NordOtto/Pumpensteuerung/hardware/bom.csv

Menge | Referenzen | Wert | Footprint | MPN/Hinweis
1 | C1 | 100µF/50V | CP_Elec_10x10.5
4 | C2 C3 C10 C11 | 10µ/50V | C_1210_3225Metric
2 | C4 C12 | 100n/50V | C_0603_1608Metric
4 | C5 C13 C23 C29 | 1µ | C_0603_1608Metric
11 | C6 C14 C18 C22 C25 C40 C41 C44 C57 C58 C60 | 100nF | C_0603_1608Metric
4 | C7 C8 C9 C33 | 22µ/16V | C_1210_3225Metric
2 | C15 C16 | 22µ/25V | C_1210_3225Metric
1 | C17 | 10µF/16V | C_0805_2012Metric
2 | C19 C20 | 22µF/10V | C_1210_3225Metric
4 | C21 C45 C56 C59 | 10µF | C_0805_2012Metric
1 | C24 | 22µF/16V | C_1210_3225Metric
1 | C26 | 10µ | C_0805_2012Metric
5 | C27 C28 C42 C43 C61 | 100n | C_0603_1608Metric
1 | C30 | 470p | C_0603_1608Metric
2 | C31 C32 | 22p | C_0603_1608Metric
6 | C34 C35 C36 C37 C38 C39 | 10n | C_0603_1608Metric
2 | C46 C49 | 100nF/50V | C_0603_1608Metric
2 | C47 C50 | 2.2nF | C_0603_1608Metric
2 | C48 C51 | 10nF/50V | C_0603_1608Metric
4 | C52 C53 C54 C55 | 10nF | C_0603_1608Metric
1 | D1 | SMAJ30A | D_SMA
1 | D2 | SS14 | D_SMA
1 | D3 | grün PWR | LED_0603_1608Metric
1 | D4 | gelb STATUS | LED_0603_1608Metric
1 | D5 | blau APP | LED_0603_1608Metric
8 | D6 D7 D8 D9 D10 D11 D13 D15 | SMAJ26A | D_SMA
8 | D12 D14 D17 D19 D21 D23 D24 D26 | 1N4148W | D_SOD-123
4 | D16 D18 D20 D22 | BZT52C9V1 | D_SOD-123
1 | D25 | rot K1 | LED_0603_1608Metric
1 | D27 | rot K2 | LED_0603_1608Metric
2 | D28 D29 | SMAJ15CA | D_SMA
1 | F1 | T2A 250V | Fuseholder_Clip-5x20mm_Keystone_3517_Inline_P23.11x6.76mm_D1.70mm_Horizontal
1 | F2 | 1.1A hold | Fuse_1812_4532Metric | Bourns MF-MSMF110-2
12 | F3 F4 F5 F6 F7 F8 F9 F10 F11 F12 F13 F14 | 50mA | Fuse_1206_3216Metric | Bourns MF-USMF005-2
1 | F15 | 200mA | Fuse_1206_3216Metric | Bourns MF-USMF020-2
1 | FB1 | 600Ω@100MHz | L_0603_1608Metric
4 | H1 H2 H3 H4 | M3 | MountingHole_3.2mm_M3
1 | J1 | 230V L/N | TerminalBlock_Phoenix_MKDS-1,5-2-5.08_1x02_P5.08mm_Horizontal
1 | J2 | USB-C S3 | USB_C_Receptacle_HRO_TYPE-C-31-M-12
1 | J3 | Erweiterung S3 | PinHeader_1x10_P2.54mm_Vertical
1 | J4 | Erweiterung P4 | PinHeader_1x05_P2.54mm_Vertical
1 | J5 | HR911105A | RJ45_Hanrun_HR911105A_Horizontal
1 | J6 | DSI 15p 1.0mm | TE_1-84952-5_1x15-1MP_P1.0mm_Horizontal | TE 1-84952-5
1 | J7 | Display 5V | PinHeader_1x02_P2.54mm_Vertical
1 | J8 | AI1 | TerminalBlock_Phoenix_PT-1,5-3-3.5-H_1x03_P3.50mm_Horizontal
1 | J9 | AI2 | TerminalBlock_Phoenix_PT-1,5-3-3.5-H_1x03_P3.50mm_Horizontal
1 | J10 | AI3 | TerminalBlock_Phoenix_PT-1,5-3-3.5-H_1x03_P3.50mm_Horizontal
1 | J11 | AI4 | TerminalBlock_Phoenix_PT-1,5-3-3.5-H_1x03_P3.50mm_Horizontal
1 | J12 | AI5 | TerminalBlock_Phoenix_PT-1,5-3-3.5-H_1x03_P3.50mm_Horizontal
1 | J13 | AI6 | TerminalBlock_Phoenix_PT-1,5-3-3.5-H_1x03_P3.50mm_Horizontal
1 | J14 | AO1 | TerminalBlock_Phoenix_PT-1,5-2-3.5-H_1x02_P3.50mm_Horizontal
1 | J15 | AO2 | TerminalBlock_Phoenix_PT-1,5-2-3.5-H_1x02_P3.50mm_Horizontal
1 | J16 | DI | TerminalBlock_Phoenix_PT-1,5-6-3.5-H_1x06_P3.50mm_Horizontal
1 | J17 | K1 | TerminalBlock_Phoenix_MKDS-1,5-3-5.08_1x03_P5.08mm_Horizontal
1 | J18 | K2 | TerminalBlock_Phoenix_MKDS-1,5-3-5.08_1x03_P5.08mm_Horizontal
1 | J19 | RS485 | TerminalBlock_Phoenix_PT-1,5-3-3.5-H_1x03_P3.50mm_Horizontal
1 | J20 | Lüfter 4-Pin | FanPinHeader_1x04_P2.54mm_Vertical
6 | JP1 JP2 JP3 JP4 JP5 JP6 | 4-20mA | PinHeader_1x02_P2.54mm_Vertical
1 | JP7 | 120Ω | PinHeader_1x02_P2.54mm_Vertical
2 | K1 K2 | 34.51.7.024.0010 | Relay_SPDT_Finder_34.51_Vertical | Finder 34.51.7.024.0010
1 | L1 | 10µH | L_Bourns_SRP7028A_7.3x6.6mm | Bourns SRP7028A-100M
1 | L2 | 22µH | L_Bourns_SRP7028A_7.3x6.6mm | Bourns SRP7028A-220M
1 | L3 | 4.7µH | L_Bourns-SRN6028 | Bourns SRN6028-4R7M
1 | PS1 | IRM-30-24 | MeanWell_IRM-30 | Mean Well IRM-30-24
5 | Q1 Q2 Q3 Q8 Q9 | 2N7002 | SOT-23
2 | Q4 Q6 | MMBT2907A | SOT-23
2 | Q5 Q7 | BSP170P | SOT-223-3_TabPin2
7 | R1 R5 R11 R13 R60 R77 R80 | 100k | R_0603_1608Metric
2 | R2 R6 | 12k | R_0603_1608Metric
3 | R3 R7 R55 | 100k 1% | R_0603_1608Metric
1 | R4 | 24.9k 1% | R_0603_1608Metric
1 | R8 | 9.09k 1% | R_0603_1608Metric
1 | R9 | 2.2k | R_0603_1608Metric
15 | R10 R12 R16 R25 R26 R53 R54 R61 R69 R71 R73 R75 R82 R84 R85 | 10k | R_0603_1608Metric
2 | R14 R15 | 5.1k | R_0603_1608Metric
2 | R17 R21 | 470 | R_0603_1608Metric
6 | R18 R19 R33 R34 R78 R81 | 4.7k | R_0603_1608Metric
4 | R20 R59 R76 R79 | 100 | R_0603_1608Metric
1 | R22 | 12.1k 1% | R_0603_1608Metric
1 | R23 | 33 | R_0603_1608Metric
1 | R24 | 1.5k | R_0603_1608Metric
4 | R27 R28 R29 R30 | 49.9 | R_0603_1608Metric
2 | R31 R32 | 330 | R_0603_1608Metric
6 | R35 R38 R41 R44 R47 R50 | 150 0.1% 1W | R_2512_6332Metric
6 | R36 R39 R42 R45 R48 R51 | 22k 0.1% | R_0603_1608Metric
6 | R37 R40 R43 R46 R49 R52 | 10k 0.1% | R_0603_1608Metric
3 | R56 R57 R58 | 10k 1% | R_0603_1608Metric
2 | R62 R65 | 1.00k 0.1% | R_0603_1608Metric
4 | R63 R64 R66 R67 | 15 | R_0603_1608Metric
4 | R68 R70 R72 R74 | 3.3k | R_1206_3216Metric
1 | R83 | 120 | R_1206_3216Metric
1 | RV1 | S10K275 | RV_Disc_D12mm_W4.2mm_P7.5mm
1 | SW1 | RESET | SW_SPST_TL3342
1 | SW2 | BOOT | SW_SPST_TL3342
1 | SW3 | SERVICE | SW_SPST_TL3342
1 | SW4 | RESET P4 | SW_SPST_TL3342
1 | SW5 | BOOT P4 | SW_SPST_TL3342
2 | U1 U2 | LMR33630ADDA | Texas_HSOP-8-1EP_3.9x4.9mm_P1.27mm_ThermalVias | LMR33630ADDAR
1 | U3 | AP63203WU-7 | TSOT-23-6 | AP63203WU-7
1 | U4 | ESP32-S3-WROOM-1-N16R8 | ESP32-S3-WROOM-1 | ESP32-S3-WROOM-1-N16R8
1 | U5 | M5Stack Stamp-P4 | M5Stack_Stamp-P4 | M5Stack S013 Stamp-P4
1 | U6 | LAN8720A-CP | VQFN-24-1EP_4x4mm_P0.5mm_EP2.5x2.5mm_ThermalVias | LAN8720A-CP-TR
2 | U7 U8 | ADS1115IDGS | TSSOP-10_3x3mm_P0.5mm
1 | U9 | MCP4728-E/UN | MSOP-10_3x3mm_P0.5mm
2 | U10 U11 | XTR111AIDGQR | MSOP-10-1EP_3x3mm_P0.5mm_EP2.2x3.1mm_Mask1.83x1.89mm_ThermalVias
1 | U12 | TLP293-4 | SOIC-16_4.55x10.3mm_P1.27mm
1 | U13 | ADM2587EBRWZ | SOIC-20W_7.5x12.8mm_P1.27mm
1 | U14 | 74LVC1G07 | SOT-23-5
1 | Y1 | 25MHz | Crystal_SMD_3225-4Pin_3.2x2.5mm
