NordOtto/Pumpensteuerung/hardware/kicad/analog_in.kicad_sch

## KiCad design hardware/kicad/analog_in.kicad_sch (2026-10-20)

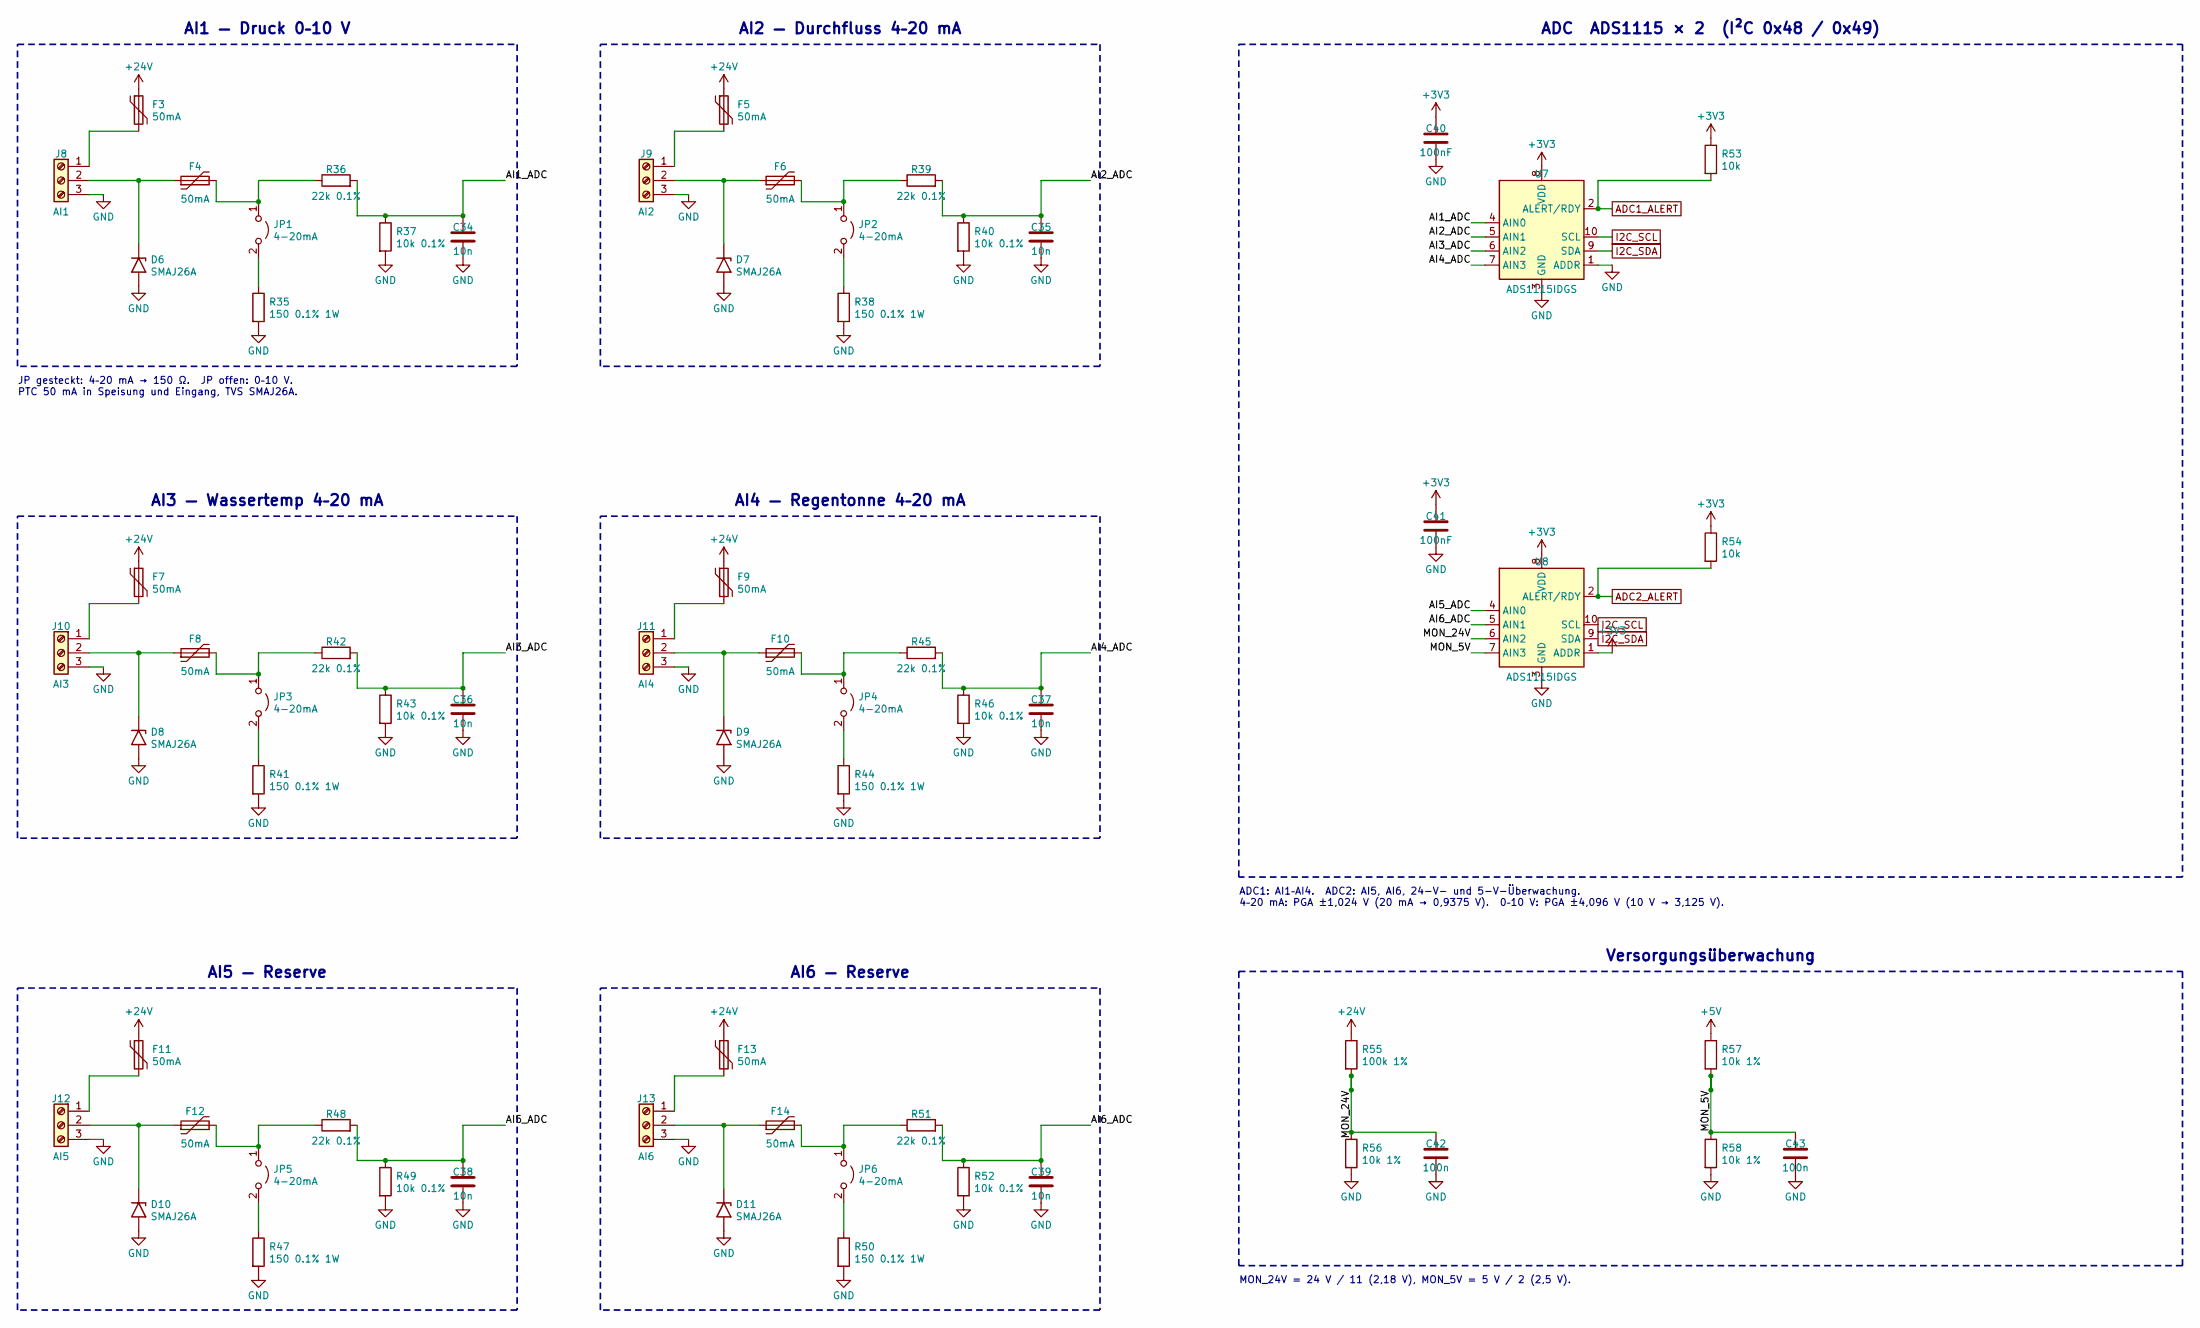
[picture p1: schematic analog_in.kicad_sch]

Parts:
C34, C35, C36, C37, C38, C39: 10n; C_0603_1608Metric
C40, C41: 100nF; C_0603_1608Metric
C42, C43: 100n; C_0603_1608Metric
D6, D7, D8, D9, D10, D11: SMAJ26A; D_SMA
F3, F4, F5, F6, F7, F8, F9, F10, F11, F12, F13, F14: 50mA; Fuse_1206_3216Metric; MPN Bourns MF-USMF005-2
J8: AI1; TerminalBlock_Phoenix_PT-1,5-3-3.5-H_1x03_P3.50mm_Horizontal
J9: AI2; TerminalBlock_Phoenix_PT-1,5-3-3.5-H_1x03_P3.50mm_Horizontal
J10: AI3; TerminalBlock_Phoenix_PT-1,5-3-3.5-H_1x03_P3.50mm_Horizontal
J11: AI4; TerminalBlock_Phoenix_PT-1,5-3-3.5-H_1x03_P3.50mm_Horizontal
J12: AI5; TerminalBlock_Phoenix_PT-1,5-3-3.5-H_1x03_P3.50mm_Horizontal
J13: AI6; TerminalBlock_Phoenix_PT-1,5-3-3.5-H_1x03_P3.50mm_Horizontal
JP1, JP2, JP3, JP4, JP5, JP6: 4-20mA; PinHeader_1x02_P2.54mm_Vertical
R35, R38, R41, R44, R47, R50: 150 0.1% 1W; R_2512_6332Metric
R36, R39, R42, R45, R48, R51: 22k 0.1%; R_0603_1608Metric
R37, R40, R43, R46, R49, R52: 10k 0.1%; R_0603_1608Metric
R53, R54: 10k; R_0603_1608Metric
R55: 100k 1%; R_0603_1608Metric
R56, R57, R58: 10k 1%; R_0603_1608Metric
U7, U8: ADS1115IDGS; TSSOP-10_3x3mm_P0.5mm

Connections:
+3V3: C40.1, C41.1, R53.1, R54.1, U7.8 (VDD), U8.1 (ADDR), U8.8 (VDD)
+5V: R57.1
+24V: F3.1, F5.1, F7.1, F9.1, F11.1, F13.1, R55.1
ADC1_ALERT: R53.2, U7.2 (ALERT/RDY)
ADC2_ALERT: R54.2, U8.2 (ALERT/RDY)
AI1_ADC: C34.1, R36.2, R37.1, U7.4 (AIN0)
AI2_ADC: C35.1, R39.2, R40.1, U7.5 (AIN1)
AI3_ADC: C36.1, R42.2, R43.1, U7.6 (AIN2)
AI4_ADC: C37.1, R45.2, R46.1, U7.7 (AIN3)
AI5_ADC: C38.1, R48.2, R49.1, U8.4 (AIN0)
AI6_ADC: C39.1, R51.2, R52.1, U8.5 (AIN1)
GND: C34.2, C35.2, C36.2, C37.2, C38.2, C39.2, C40.2, C41.2, C42.2, C43.2, D6.2 (A2), D7.2 (A2), D8.2 (A2), D9.2 (A2), D10.2 (A2), D11.2 (A2), J8.3, J9.3, J10.3, J11.3, J12.3, J13.3, R35.2, R37.2, R38.2, R40.2, R41.2, R43.2, R44.2, R46.2, R47.2, R49.2, R50.2, R52.2, R56.2, R58.2, U7.1 (ADDR), U7.3 (GND), U8.3 (GND)
I2C_SCL: U7.10 (SCL), U8.10 (SCL)
I2C_SDA: U7.9 (SDA), U8.9 (SDA)
MON_5V: C43.1, R57.2, R58.1, U8.7 (AIN3)
MON_24V: C42.1, R55.2, R56.1, U8.6 (AIN2)
unnamed: D6.1 (A1), F4.1, J8.2
unnamed: D7.1 (A1), F6.1, J9.2
unnamed: D8.1 (A1), F8.1, J10.2
unnamed: D9.1 (A1), F10.1, J11.2
unnamed: D10.1 (A1), F12.1, J12.2
unnamed: D11.1 (A1), F14.1, J13.2
unnamed: F3.2, J8.1
unnamed: F4.2, JP1.1 (A), R36.1
unnamed: F5.2, J9.1
unnamed: F6.2, JP2.1 (A), R39.1
unnamed: F7.2, J10.1
unnamed: F8.2, JP3.1 (A), R42.1
unnamed: F9.2, J11.1
unnamed: F10.2, JP4.1 (A), R45.1
unnamed: F11.2, J12.1
unnamed: F12.2, JP5.1 (A), R48.1
unnamed: F13.2, J13.1
unnamed: F14.2, JP6.1 (A), R51.1
unnamed: JP1.2 (B), R35.1
unnamed: JP2.2 (B), R38.1
unnamed: JP3.2 (B), R41.1
unnamed: JP4.2 (B), R44.1
unnamed: JP5.2 (B), R47.1
unnamed: JP6.2 (B), R50.1

Notes on the sheet:
AI1 — Druck 0–10 V
JP gesteckt: 4–20 mA → 150 Ω. JP offen: 0–10 V. PTC 50 mA in Speisung und Eingang, TVS SMAJ26A.
AI2 — Durchfluss 4–20 mA
AI3 — Wassertemp 4–20 mA
AI4 — Regentonne 4–20 mA
AI5 — Reserve
AI6 — Reserve
ADC ADS1115 × 2 (I²C 0x48 / 0x49)
ADC1: AI1–AI4. ADC2: AI5, AI6, 24-V- und 5-V-Überwachung. 4–20 mA: PGA ±1,024 V (20 mA → 0,9375 V). 0–10 V: PGA ±4,096 V (10 V → 3,125 V).
Versorgungsüberwachung
MON_24V = 24 V / 11 (2,18 V), MON_5V = 5 V / 2 (2,5 V).
