NordOtto/Pumpensteuerung/hardware/kicad/analog_out.kicad_sch

## KiCad design hardware/kicad/analog_out.kicad_sch (2026-10-20)

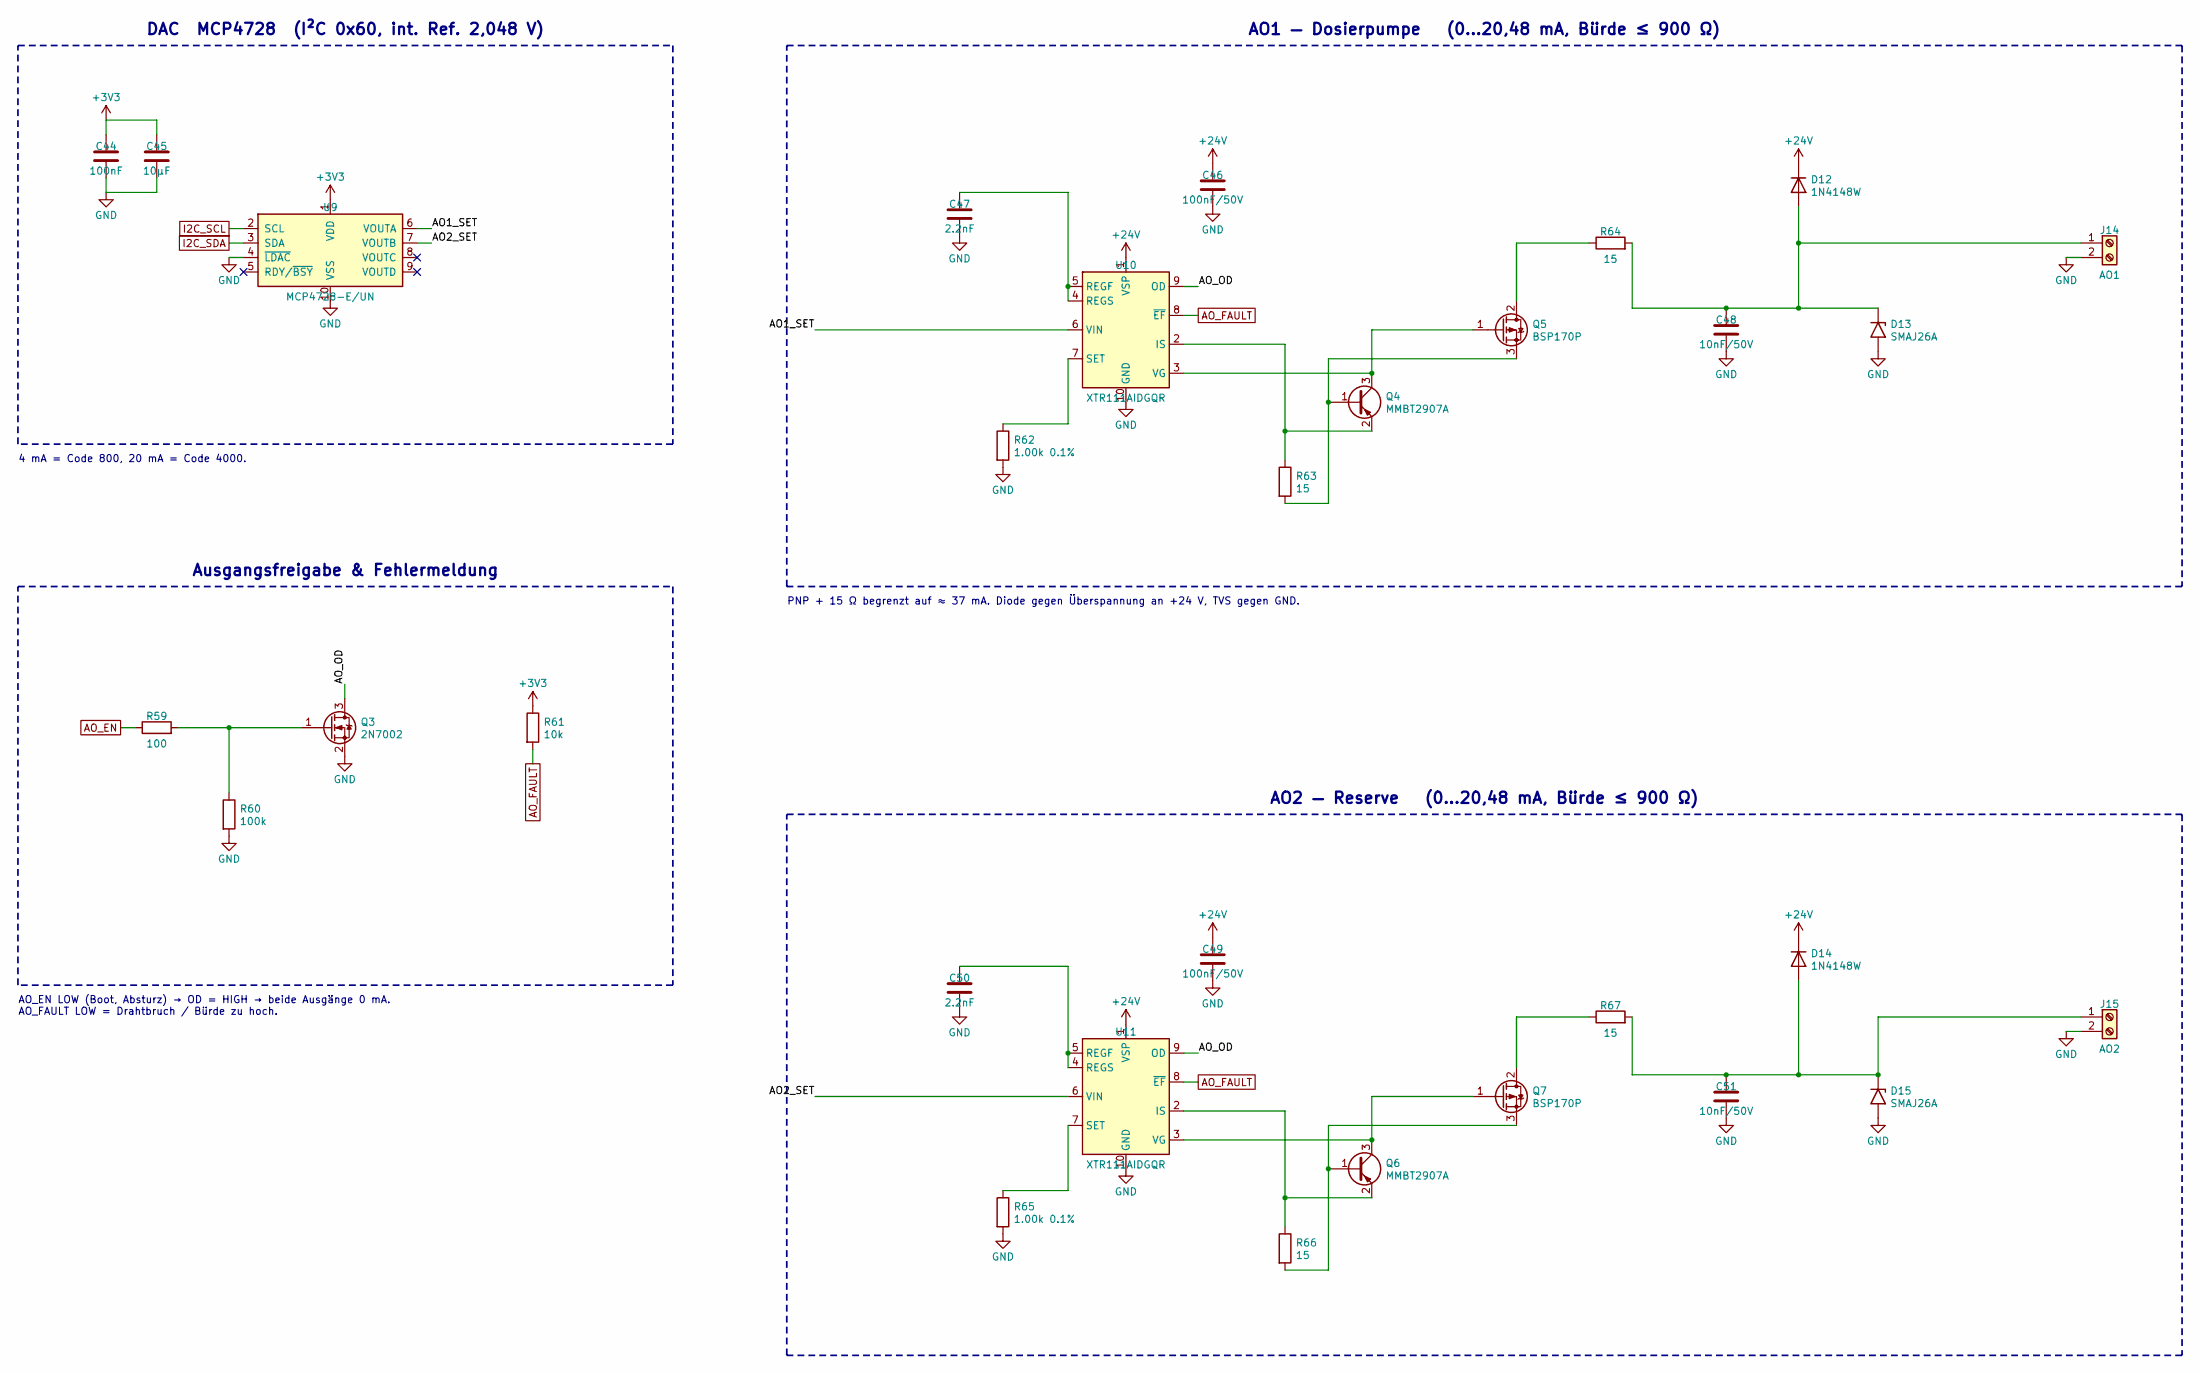
[picture p2: schematic analog_out.kicad_sch]

Parts:
C44: 100nF; C_0603_1608Metric
C45: 10µF; C_0805_2012Metric
C46, C49: 100nF/50V; C_0603_1608Metric
C47, C50: 2.2nF; C_0603_1608Metric
C48, C51: 10nF/50V; C_0603_1608Metric
D12, D14: 1N4148W; D_SOD-123
D13, D15: SMAJ26A; D_SMA
J14: AO1; TerminalBlock_Phoenix_PT-1,5-2-3.5-H_1x02_P3.50mm_Horizontal
J15: AO2; TerminalBlock_Phoenix_PT-1,5-2-3.5-H_1x02_P3.50mm_Horizontal
Q3: 2N7002; SOT-23
Q4, Q6: MMBT2907A; SOT-23
Q5, Q7: BSP170P; SOT-223-3_TabPin2
R59: 100; R_0603_1608Metric
R60: 100k; R_0603_1608Metric
R61: 10k; R_0603_1608Metric
R62, R65: 1.00k 0.1%; R_0603_1608Metric
R63, R64, R66, R67: 15; R_0603_1608Metric
U9: MCP4728-E/UN; MSOP-10_3x3mm_P0.5mm
U10, U11: XTR111AIDGQR; MSOP-10-1EP_3x3mm_P0.5mm_EP2.2x3.1mm_Mask1.83x1.89mm_Therma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

Connections:
+3V3: C44.1, C45.1, R61.1, U9.1 (VDD)
+24V: C46.1, C49.1, D12.1 (K), D14.1 (K), U10.1 (VSP), U11.1 (VSP)
AO1_SET: U9.6 (VOUTA), U10.6 (VIN)
AO2_SET: U9.7 (VOUTB), U11.6 (VIN)
AO_EN: R59.1
AO_FAULT: R61.2, U10.8 (~EF), U11.8 (~EF)
AO_OD: Q3.3 (D), U10.9 (OD), U11.9 (OD)
GND: C44.2, C45.2, C46.2, C47.2, C48.2, C49.2, C50.2, C51.2, D13.2 (A2), D15.2 (A2), J14.2, J15.2, Q3.2 (S), R60.2, R62.2, R65.2, U9.4 (~LDAC), U9.10 (VSS), U10.10 (GND), U10.11 (GND), U11.10 (GND), U11.11 (GND)
I2C_SCL: U9.2 (SCL)
I2C_SDA: U9.3 (SDA)
unnamed: C47.1, U10.4 (REGS), U10.5 (REGF)
unnamed: C48.1, D12.2 (A), D13.1 (A1), J14.1, R64.2
unnamed: C50.1, U11.4 (REGS), U11.5 (REGF)
unnamed: C51.1, D14.2 (A), D15.1 (A1), J15.1, R67.2
unnamed: Q3.1 (G), R59.2, R60.1
unnamed: Q4.1 (B), Q5.3 (S), R63.2
unnamed: Q4.2 (E), R63.1, U10.2 (IS)
unnamed: Q4.3 (C), Q5.1 (G), U10.3 (VG)
unnamed: Q5.2 (D), R64.1
unnamed: Q6.1 (B), Q7.3 (S), R66.2
unnamed: Q6.2 (E), R66.1, U11.2 (IS)
unnamed: Q6.3 (C), Q7.1 (G), U11.3 (VG)
unnamed: Q7.2 (D), R67.1
unnamed: R62.1, U10.7 (SET)
unnamed: R65.1, U11.7 (SET)

Notes on the sheet:
DAC MCP4728 (I²C 0x60, int. Ref. 2,048 V)
4 mA = Code 800, 20 mA = Code 4000.
Ausgangsfreigabe & Fehlermeldung
AO_EN LOW (Boot, Absturz) → OD = HIGH → beide Ausgänge 0 mA. AO_FAULT LOW = Drahtbruch / Bürde zu hoch.
AO1 — Dosierpumpe (0…20,48 mA, Bürde ≤ 900 Ω)
PNP + 15 Ω begrenzt auf ≈ 37 mA. Diode gegen Überspannung an +24 V, TVS gegen GND.
AO2 — Reserve (0…20,48 mA, Bürde ≤ 900 Ω)
