NordOtto/Pumpensteuerung/hardware/kicad/cm5.kicad_sch

## KiCad design hardware/kicad/cm5.kicad_sch (2026-10-20)

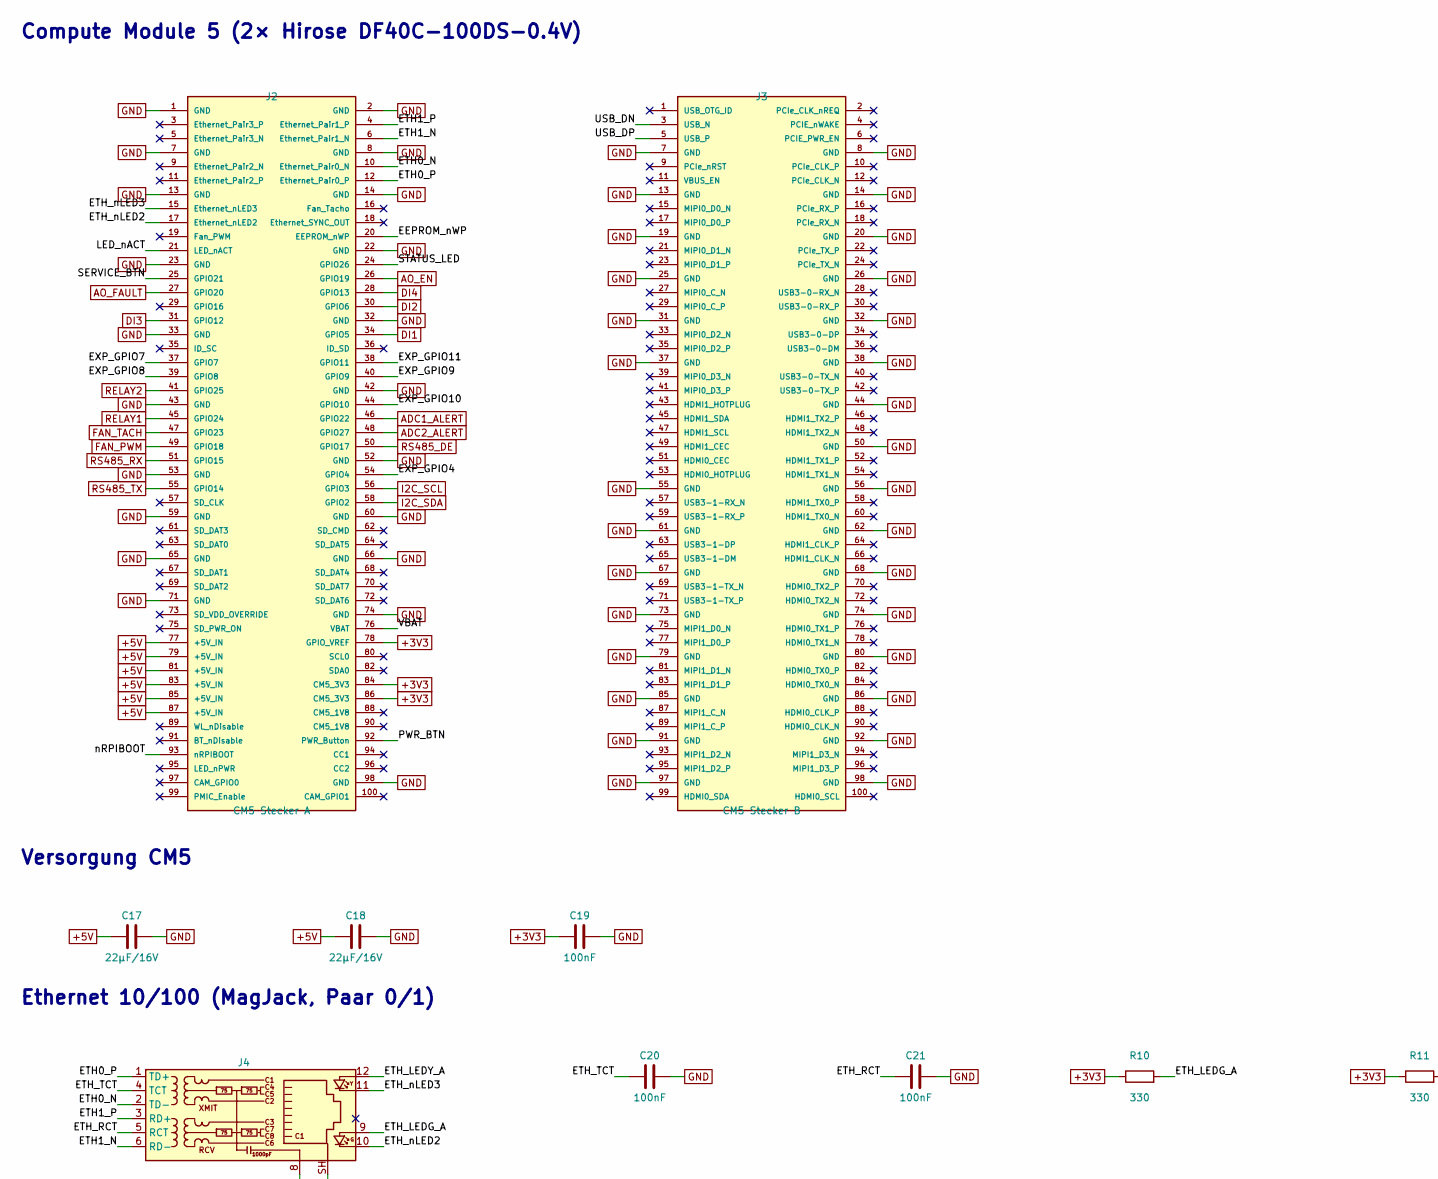
[picture p3: schematic cm5.kicad_sch, part in row 1, column 1]

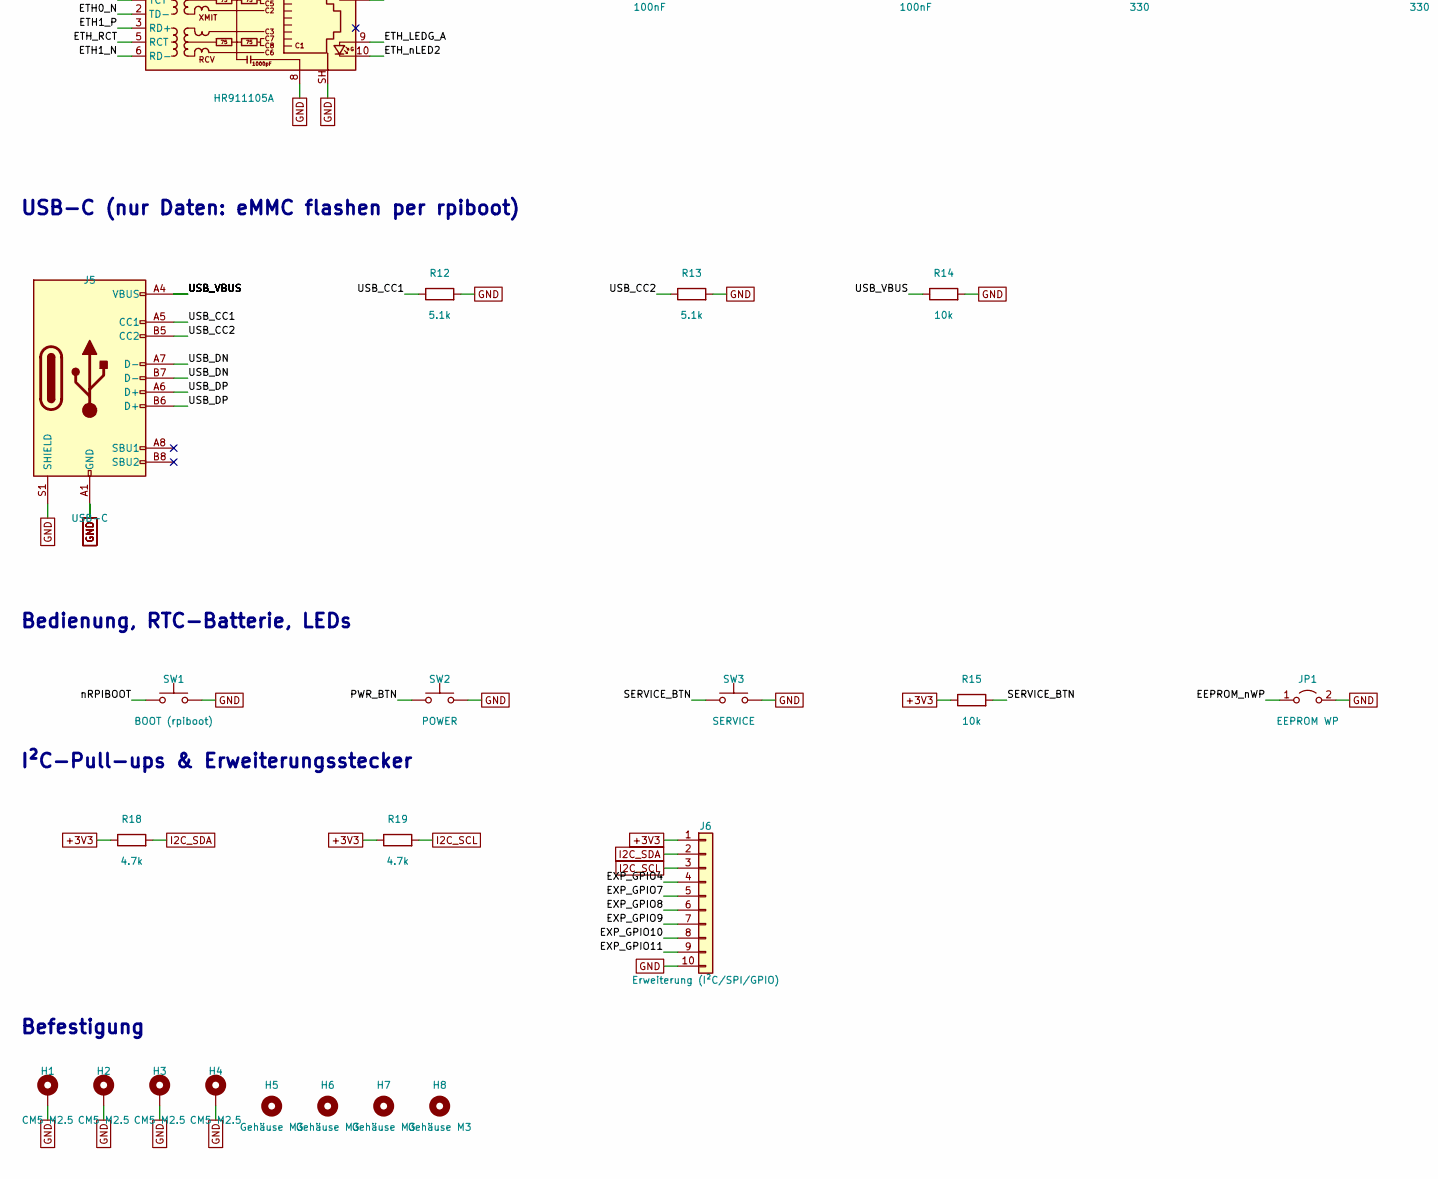
[picture p4: schematic cm5.kicad_sch, part in row 2, column 1]

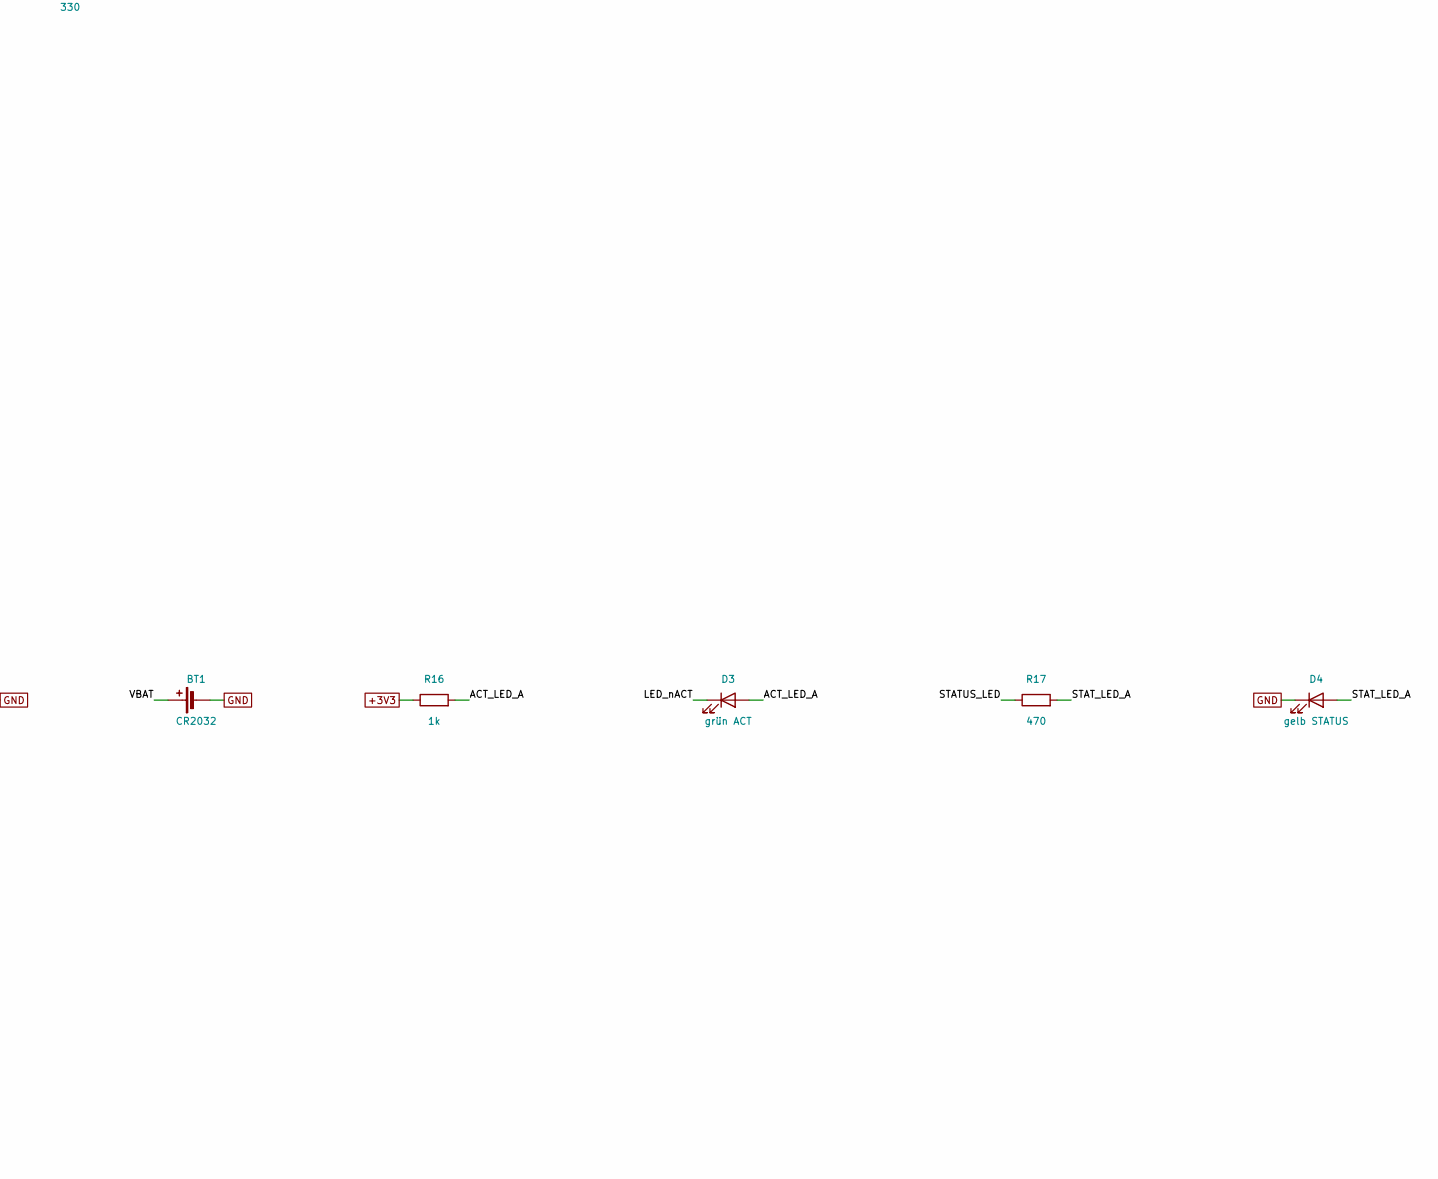
[picture p5: schematic cm5.kicad_sch, part in row 2, column 2]

Parts:
BT1: CR2032; BatteryHolder_Keystone_3002_1x2032
C17, C18: 22µF/16V; C_1210_3225Metric
C19, C20, C21: 100nF; C_0603_1608Metric
D3: grün ACT; LED_0603_1608Metric
D4: gelb STATUS; LED_0603_1608Metric
H1, H2, H3, H4: CM5 M2.5; MountingHole_2.7mm_M2.5_Pad_Via
H5, H6, H7, H8: Gehäuse M3; MountingHole_3.2mm_M3
J2: CM5 Stecker A; Hirose_DF40C-100DS-0.4V; MPN Hirose DF40C-100DS-0.4V(51)
J3: CM5 Stecker B; Hirose_DF40C-100DS-0.4V; MPN Hirose DF40C-100DS-0.4V(51)
J4: HR911105A; RJ45_Hanrun_HR911105A_Horizontal
J5: USB-C; USB_C_Receptacle_HRO_TYPE-C-31-M-12
J6: Erweiterung (I²C/SPI/GPIO); PinHeader_1x10_P2.54mm_Vertical
JP1: EEPROM WP; PinHeader_1x02_P2.54mm_Vertical
R10, R11: 330; R_0603_1608Metric
R12, R13: 5.1k; R_0603_1608Metric
R14, R15: 10k; R_0603_1608Metric
R16: 1k; R_0603_1608Metric
R17: 470; R_0603_1608Metric
R18, R19: 4.7k; R_0603_1608Metric
SW1: BOOT (rpiboot); SW_SPST_TL3342
SW2: POWER; SW_SPST_TL3342
SW3: SERVICE; SW_SPST_TL3342

Connections:
+3V3: C19.1, J2.78 (GPIO_VREF), J2.84 (CM5_3V3), J2.86 (CM5_3V3), J6.1, R10.1, R11.1, R15.1, R16.1, R18.1, R19.1
+5V: C17.1, C18.1, J2.77 (+5V_IN), J2.79 (+5V_IN), J2.81 (+5V_IN), J2.83 (+5V_IN), J2.85 (+5V_IN), J2.87 (+5V_IN)
ACT_LED_A: D3.2 (A), R16.2
ADC1_ALERT: J2.46 (GPIO22)
ADC2_ALERT: J2.48 (GPIO27)
AO_EN: J2.26 (GPIO19)
AO_FAULT: J2.27 (GPIO20)
DI1: J2.34 (GPIO5)
DI2: J2.30 (GPIO6)
DI3: J2.31 (GPIO12)
DI4: J2.28 (GPIO13)
EEPROM_nWP: J2.20 (EEPROM_nWP), JP1.1 (A)
ETH0_N: J2.10 (Ethernet_Pair0_N), J4.2 (TD-)
ETH0_P: J2.12 (Ethernet_Pair0_P), J4.1 (TD+)
ETH1_N: J2.6 (Ethernet_Pair1_N), J4.6 (RD-)
ETH1_P: J2.4 (Ethernet_Pair1_P), J4.3 (RD+)
ETH_LEDG_A: J4.9, R10.2
ETH_LEDY_A: J4.12, R11.2
ETH_RCT: C21.1, J4.5 (RCT)
ETH_TCT: C20.1, J4.4 (TCT)
ETH_nLED2: J2.17 (Ethernet_nLED2), J4.10
ETH_nLED3: J2.15 (Ethernet_nLED3), J4.11
EXP_GPIO4: J2.54 (GPIO4), J6.4
EXP_GPIO7: J2.37 (GPIO7), J6.5
EXP_GPIO8: J2.39 (GPIO8), J6.6
EXP_GPIO9: J2.40 (GPIO9), J6.7
EXP_GPIO10: J2.44 (GPIO10), J6.8
EXP_GPIO11: J2.38 (GPIO11), J6.9
FAN_PWM: J2.49 (GPIO18)
FAN_TACH: J2.47 (GPIO23)
GND: BT1.2 (-), C17.2, C18.2, C19.2, C20.2, C21.2, D4.1 (K), H1.1, H2.1, H3.1, H4.1, J2.1 (GND), J2.2 (GND), J2.7 (GND), J2.8 (GND), J2.13 (GND), J2.14 (GND), J2.22 (GND), J2.23 (GND), J2.32 (GND), J2.33 (GND), J2.42 (GND), J2.43 (GND), J2.52 (GND), J2.53 (GND), J2.59 (GND), J2.60 (GND), J2.65 (GND), J2.66 (GND), J2.71 (GND), J2.74 (GND), J2.98 (GND), J3.7 (GND), J3.8 (GND), J3.13 (GND), J3.14 (GND), J3.19 (GND), J3.20 (GND), J3.25 (GND), J3.26 (GND), J3.31 (GND), J3.32 (GND), J3.37 (GND), J3.38 (GND), J3.44 (GND), J3.50 (GND), J3.55 (GND), J3.56 (GND), J3.61 (GND), J3.62 (GND), J3.67 (GND), J3.68 (GND), J3.73 (GND), J3.74 (GND), J3.79 (GND), J3.80 (GND), J3.85 (GND), J3.86 (GND), J3.91 (GND), J3.92 (GND), J3.97 (GND), J3.98 (GND), J4.8, J4.SH, J5.A1 (GND), J5.A12 (GND), J5.B1 (GND), J5.B12 (GND), J5.S1 (SHIELD), J6.10, JP1.2 (B), R12.2, R13.2, R14.2, SW1.2, SW2.2, SW3.2
I2C_SCL: J2.56 (GPIO3), J6.3, R19.2
I2C_SDA: J2.58 (GPIO2), J6.2, R18.2
LED_nACT: D3.1 (K), J2.21 (LED_nACT)
PWR_BTN: J2.92 (PWR_Button), SW2.1
RELAY1: J2.45 (GPIO24)
RELAY2: J2.41 (GPIO25)
RS485_DE: J2.50 (GPIO17)
RS485_RX: J2.51 (GPIO15)
RS485_TX: J2.55 (GPIO14)
SERVICE_BTN: J2.25 (GPIO21), R15.2, SW3.1
STATUS_LED: J2.24 (GPIO26), R17.1
STAT_LED_A: D4.2 (A), R17.2
USB_CC1: J5.A5 (CC1), R12.1
USB_CC2: J5.B5 (CC2), R13.1
USB_DN: J3.3 (USB_N), J5.A7 (D-), J5.B7 (D-)
USB_DP: J3.5 (USB_P), J5.A6 (D+), J5.B6 (D+)
USB_VBUS: J5.A4 (VBUS), J5.A9 (VBUS), J5.B4 (VBUS), J5.B9 (VBUS), R14.1
VBAT: BT1.1 (+), J2.76 (VBAT)
nRPIBOOT: J2.93 (nRPIBOOT), SW1.1

Notes on the sheet:
Compute Module 5 (2× Hirose DF40C-100DS-0.4V)
Versorgung CM5
Ethernet 10/100 (MagJack, Paar 0/1)
USB-C (nur Daten: eMMC flashen per rpiboot)
Bedienung, RTC-Batterie, LEDs
I²C-Pull-ups & Erweiterungsstecker
Befestigung
