NordOtto/Pumpensteuerung/hardware/kicad/ctrl_s3.kicad_sch

## KiCad design hardware/kicad/ctrl_s3.kicad_sch (2026-10-20)

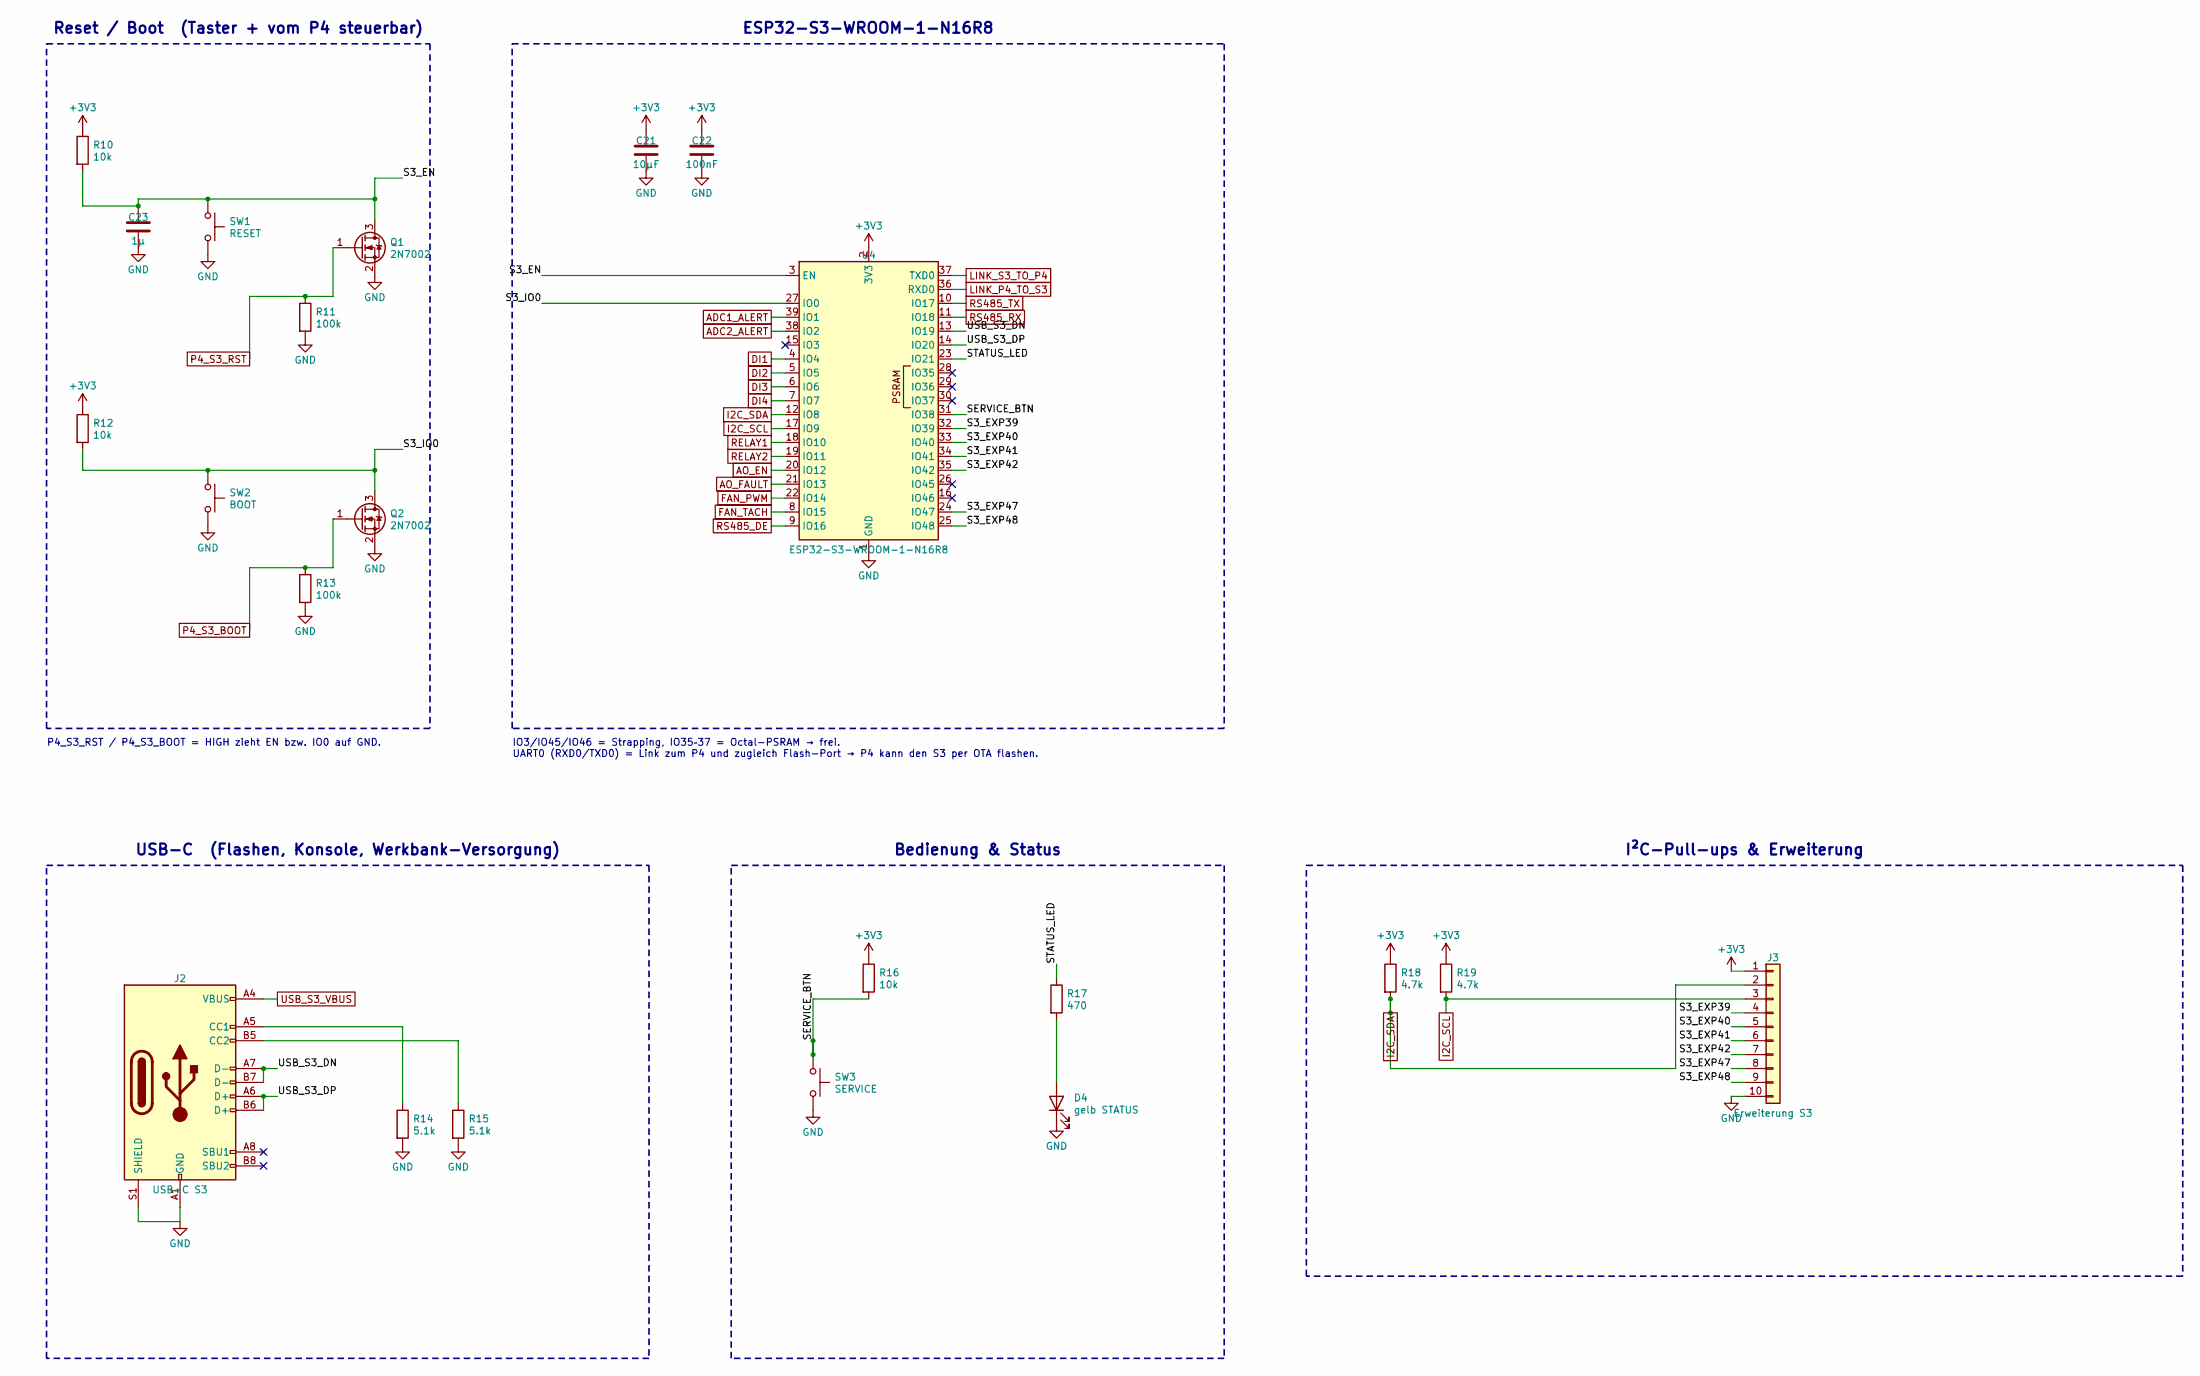
[picture p6: schematic ctrl_s3.kicad_sch]

Parts:
C21: 10µF; C_0805_2012Metric
C22: 100nF; C_0603_1608Metric
C23: 1µ; C_0603_1608Metric
D4: gelb STATUS; LED_0603_1608Metric
J2: USB-C S3; USB_C_Receptacle_HRO_TYPE-C-31-M-12
J3: Erweiterung S3; PinHeader_1x10_P2.54mm_Vertical
Q1, Q2: 2N7002; SOT-23
R10, R12, R16: 10k; R_0603_1608Metric
R11, R13: 100k; R_0603_1608Metric
R14, R15: 5.1k; R_0603_1608Metric
R17: 470; R_0603_1608Metric
R18, R19: 4.7k; R_0603_1608Metric
SW1: RESET; SW_SPST_TL3342
SW2: BOOT; SW_SPST_TL3342
SW3: SERVICE; SW_SPST_TL3342
U4: ESP32-S3-WROOM-1-N16R8; ESP32-S3-WROOM-1; MPN ESP32-S3-WROOM-1-N16R8

Connections:
+3V3: C21.1, C22.1, J3.1, R10.1, R12.1, R16.1, R18.1, R19.1, U4.2 (3V3)
ADC1_ALERT: U4.39 (IO1)
ADC2_ALERT: U4.38 (IO2)
AO_EN: U4.20 (IO12)
AO_FAULT: U4.21 (IO13)
DI1: U4.4 (IO4)
DI2: U4.5 (IO5)
DI3: U4.6 (IO6)
DI4: U4.7 (IO7)
FAN_PWM: U4.22 (IO14)
FAN_TACH: U4.8 (IO15)
GND: C21.2, C22.2, C23.2, D4.1 (K), J2.A1 (GND), J2.A12 (GND), J2.B1 (GND), J2.B12 (GND), J2.S1 (SHIELD), J3.10, Q1.2 (S), Q2.2 (S), R11.2, R13.2, R14.2, R15.2, SW1.2, SW2.2, SW3.2, U4.1 (GND), U4.40 (GND), U4.41 (GND)
I2C_SCL: J3.3, R19.2, U4.17 (IO9)
I2C_SDA: J3.2, R18.2, U4.12 (IO8)
LINK_P4_TO_S3: U4.36 (RXD0)
LINK_S3_TO_P4: U4.37 (TXD0)
unnamed: D4.2 (A), R17.2
unnamed: J2.A5 (CC1), R14.1
unnamed: J2.B5 (CC2), R15.1
P4_S3_BOOT: Q2.1 (G), R13.1
P4_S3_RST: Q1.1 (G), R11.1
RELAY1: U4.18 (IO10)
RELAY2: U4.19 (IO11)
RS485_DE: U4.9 (IO16)
RS485_RX: U4.11 (IO18)
RS485_TX: U4.10 (IO17)
S3_EN: C23.1, Q1.3 (D), R10.2, SW1.1, U4.3 (EN)
S3_EXP39: J3.4, U4.32 (IO39)
S3_EXP40: J3.5, U4.33 (IO40)
S3_EXP41: J3.6, U4.34 (IO41)
S3_EXP42: J3.7, U4.35 (IO42)
S3_EXP47: J3.8, U4.24 (IO47)
S3_EXP48: J3.9, U4.25 (IO48)
S3_IO0: Q2.3 (D), R12.2, SW2.1, U4.27 (IO0)
SERVICE_BTN: R16.2, SW3.1, U4.31 (IO38)
STATUS_LED: R17.1, U4.23 (IO21)
USB_S3_DN: J2.A7 (D-), J2.B7 (D-), U4.13 (IO19)
USB_S3_DP: J2.A6 (D+), J2.B6 (D+), U4.14 (IO20)
USB_S3_VBUS: J2.A4 (VBUS), J2.A9 (VBUS), J2.B4 (VBUS), J2.B9 (VBUS)

Notes on the sheet:
ESP32-S3-WROOM-1-N16R8
IO3/IO45/IO46 = Strapping, IO35–37 = Octal-PSRAM → frei. UART0 (RXD0/TXD0) = Link zum P4 und zugleich Flash-Port → P4 kann den S3 per OTA flashen.
Reset / Boot (Taster + vom P4 steuerbar)
P4_S3_RST / P4_S3_BOOT = HIGH zieht EN bzw. IO0 auf GND.
USB-C (Flashen, Konsole, Werkbank-Versorgung)
Bedienung & Status
I²C-Pull-ups & Erweiterung
