NordOtto/Pumpensteuerung/hardware/kicad/hmi_p4.kicad_sch

## KiCad design hardware/kicad/hmi_p4.kicad_sch (2026-10-20)

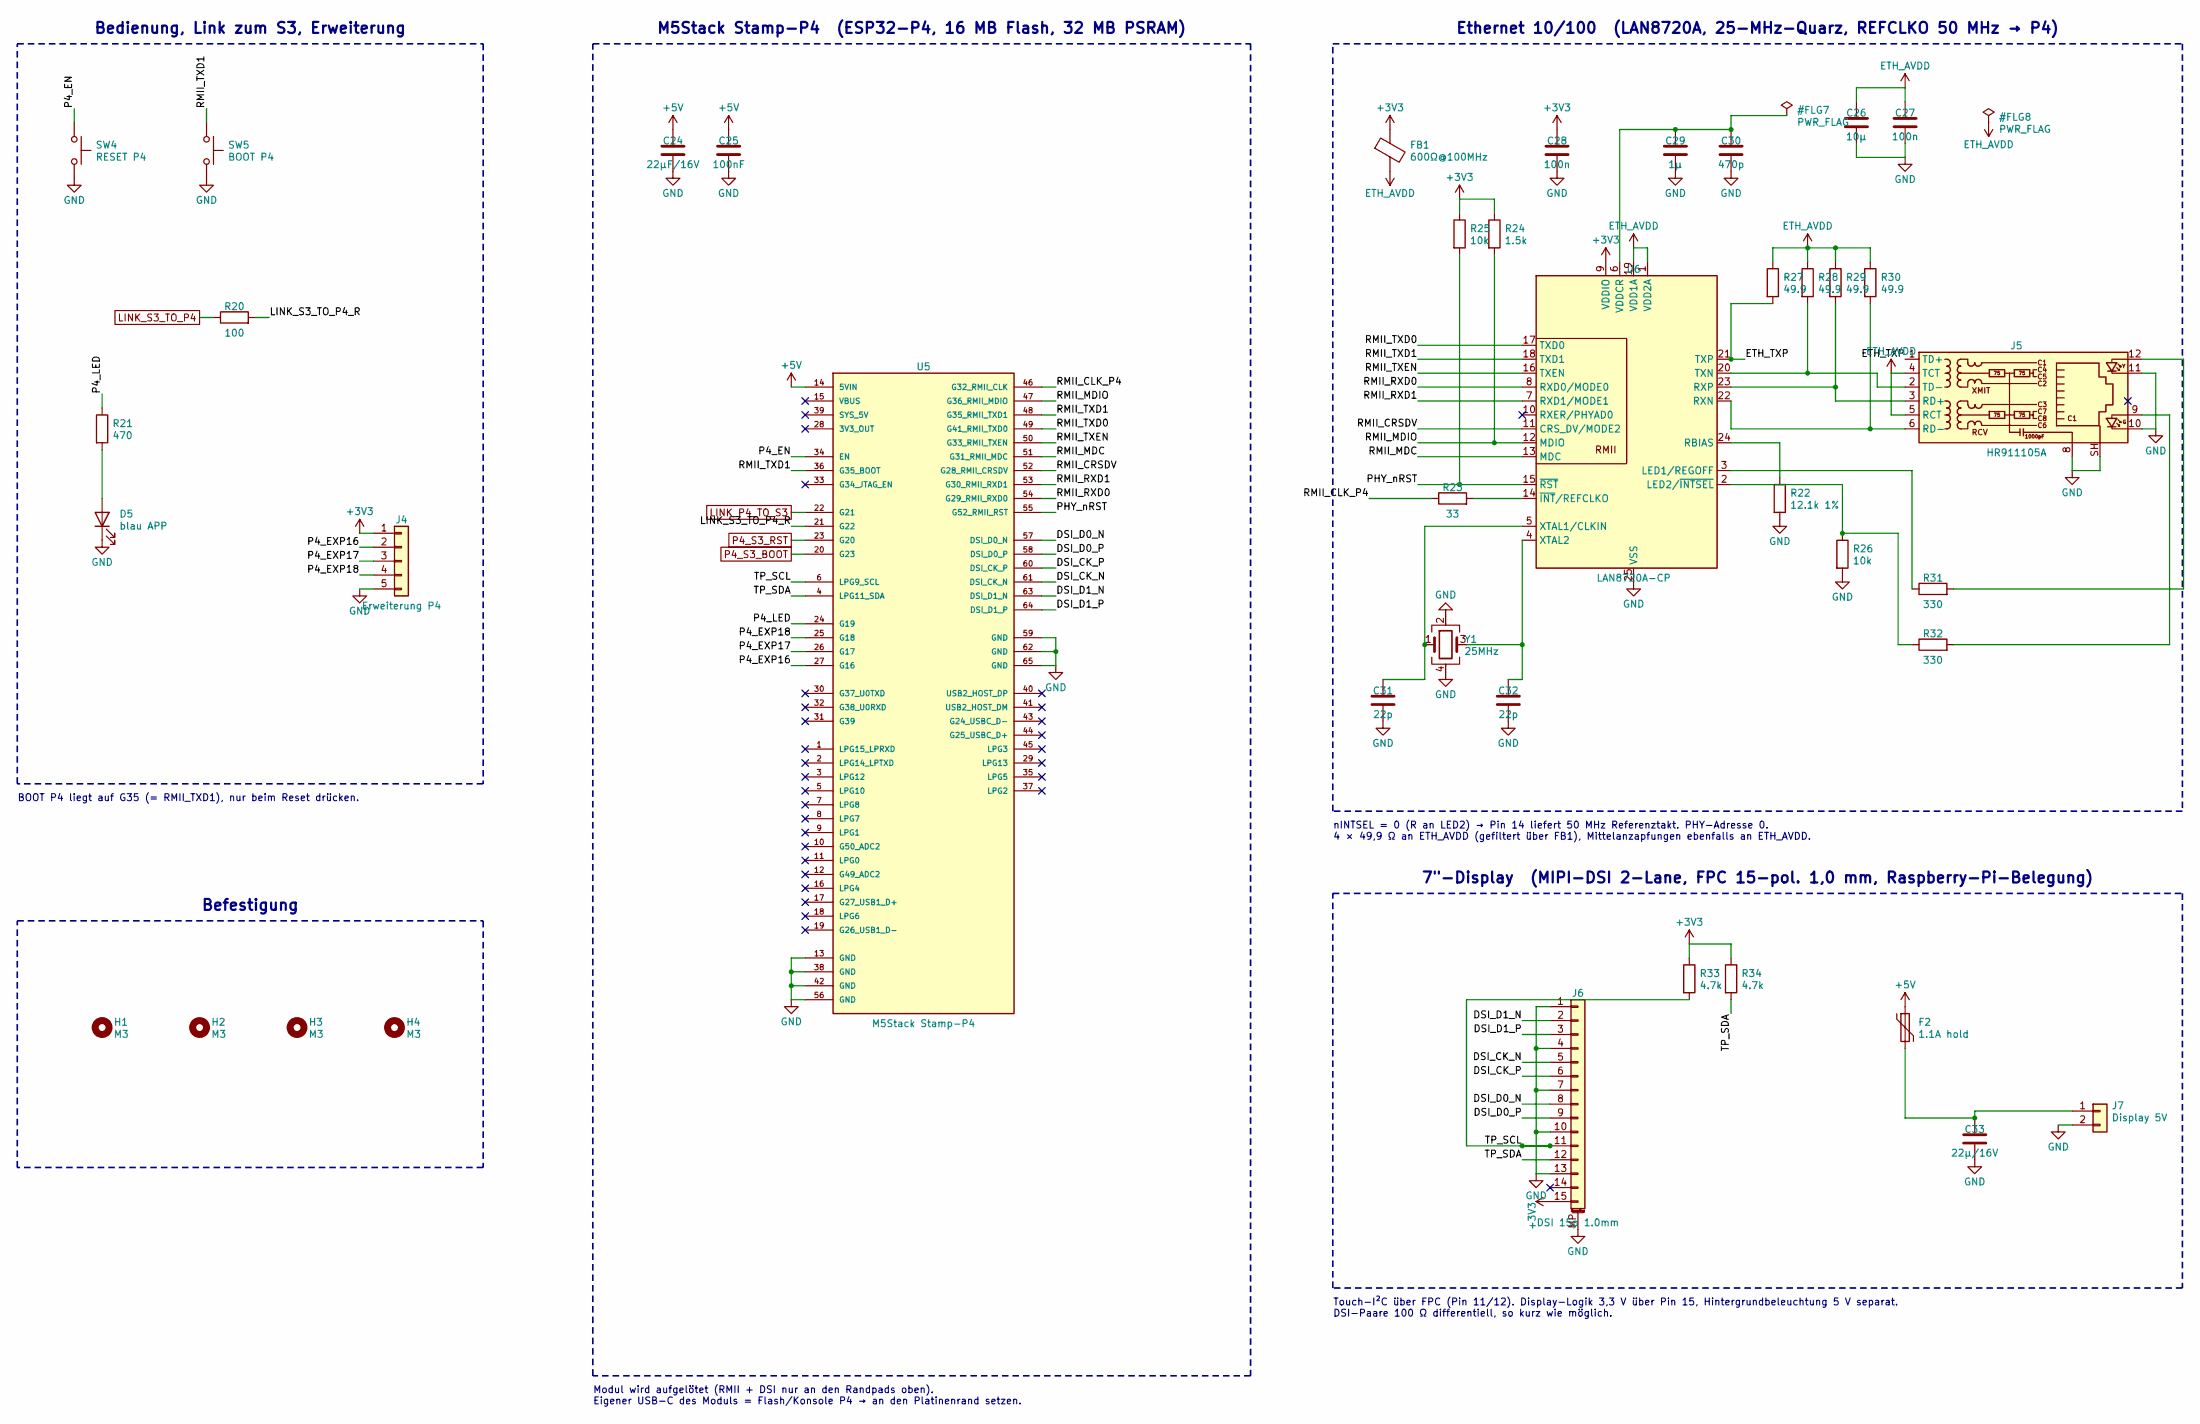
[picture p7: schematic hmi_p4.kicad_sch]

Parts:
C24: 22µF/16V; C_1210_3225Metric
C25: 100nF; C_0603_1608Metric
C26: 10µ; C_0805_2012Metric
C27, C28: 100n; C_0603_1608Metric
C29: 1µ; C_0603_1608Metric
C30: 470p; C_0603_1608Metric
C31, C32: 22p; C_0603_1608Metric
C33: 22µ/16V; C_1210_3225Metric
D5: blau APP; LED_0603_1608Metric
F2: 1.1A hold; Fuse_1812_4532Metric; MPN Bourns MF-MSMF110-2
FB1: 600Ω@100MHz; L_0603_1608Metric
H1, H2, H3, H4: M3; MountingHole_3.2mm_M3
J4: Erweiterung P4; PinHeader_1x05_P2.54mm_Vertical
J5: HR911105A; RJ45_Hanrun_HR911105A_Horizontal
J6: DSI 15p 1.0mm; TE_1-84952-5_1x15-1MP_P1.0mm_Horizontal; MPN TE 1-84952-5
J7: Display 5V; PinHeader_1x02_P2.54mm_Vertical
R20: 100; R_0603_1608Metric
R21: 470; R_0603_1608Metric
R22: 12.1k 1%; R_0603_1608Metric
R23: 33; R_0603_1608Metric
R24: 1.5k; R_0603_1608Metric
R25, R26: 10k; R_0603_1608Metric
R27, R28, R29, R30: 49.9; R_0603_1608Metric
R31, R32: 330; R_0603_1608Metric
R33, R34: 4.7k; R_0603_1608Metric
SW4: RESET P4; SW_SPST_TL3342
SW5: BOOT P4; SW_SPST_TL3342
U5: M5Stack Stamp-P4; M5Stack_Stamp-P4; MPN M5Stack S013 Stamp-P4
U6: LAN8720A-CP; VQFN-24-1EP_4x4mm_P0.5mm_EP2.5x2.5mm_ThermalVias; MPN LAN8720A-CP-TR
Y1: 25MHz; Crystal_SMD_3225-4Pin_3.2x2.5mm

Connections:
+3V3: C28.1, FB1.1, J4.1, J6.15, R24.1, R25.1, R33.1, R34.1, U6.9 (VDDIO)
+5V: C24.1, C25.1, F2.1, U5.14 (5VIN)
DSI_CK_N: J6.5, U5.61 (DSI_CK_N)
DSI_CK_P: J6.6, U5.60 (DSI_CK_P)
DSI_D0_N: J6.8, U5.57 (DSI_D0_N)
DSI_D0_P: J6.9, U5.58 (DSI_D0_P)
DSI_D1_N: J6.2, U5.63 (DSI_D1_N)
DSI_D1_P: J6.3, U5.64 (DSI_D1_P)
ETH_AVDD: C26.1, C27.1, FB1.2, J5.4 (TCT), J5.5 (RCT), R27.1, R28.1, R29.1, R30.1, U6.1 (VDD2A), U6.19 (VDD1A)
ETH_TXP: J5.1 (TD+), R27.2, U6.21 (TXP)
GND: C24.2, C25.2, C26.2, C27.2, C28.2, C29.2, C30.2, C31.2, C32.2, C33.2, D5.1 (K), J4.5, J5.8, J5.10, J5.11, J5.SH, J6.1, J6.4, J6.7, J6.10, J6.13, J6.MP (MountPin), J7.2, R22.2, R26.2, SW4.2, SW5.2, U5.13 (GND), U5.38 (GND), U5.42 (GND), U5.56 (GND), U5.59 (GND), U5.62 (GND), U5.65 (GND), U6.25 (VSS), Y1.2, Y1.4
LINK_P4_TO_S3: U5.22 (G21)
LINK_S3_TO_P4: R20.1
LINK_S3_TO_P4_R: R20.2, U5.21 (G22)
unnamed: C29.1, C30.1, U6.6 (VDDCR)
unnamed: C31.1, U6.5 (XTAL1/CLKIN), Y1.1
unnamed: C32.1, U6.4 (XTAL2), Y1.3
unnamed: C33.1, F2.2, J7.1
unnamed: D5.2 (A), R21.2
unnamed: J5.2 (TD-), R28.2, U6.20 (TXN)
unnamed: J5.3 (RD+), R29.2, U6.23 (RXP)
unnamed: J5.6 (RD-), R30.2, U6.22 (RXN)
unnamed: J5.9, R32.2
unnamed: J5.12, R31.2
unnamed: R22.1, U6.24 (RBIAS)
unnamed: R23.2, U6.14 (~INT/REFCLKO)
unnamed: R26.1, R32.1, U6.2 (LED2/~INTSEL)
unnamed: R31.1, U6.3 (LED1/REGOFF)
P4_EN: SW4.1, U5.34 (EN)
P4_EXP16: J4.2, U5.27 (G16)
P4_EXP17: J4.3, U5.26 (G17)
P4_EXP18: J4.4, U5.25 (G18)
P4_LED: R21.1, U5.24 (G19)
P4_S3_BOOT: U5.20 (G23)
P4_S3_RST: U5.23 (G20)
PHY_nRST: R25.2, U5.55 (G52_RMII_RST), U6.15 (~RST)
RMII_CLK_P4: R23.1, U5.46 (G32_RMII_CLK)
RMII_CRSDV: U5.52 (G28_RMII_CRSDV), U6.11 (CRS_DV/MODE2)
RMII_MDC: U5.51 (G31_RMII_MDC), U6.13 (MDC)
RMII_MDIO: R24.2, U5.47 (G36_RMII_MDIO), U6.12 (MDIO)
RMII_RXD0: U5.54 (G29_RMII_RXD0), U6.8 (RXD0/MODE0)
RMII_RXD1: U5.53 (G30_RMII_RXD1), U6.7 (RXD1/MODE1)
RMII_TXD0: U5.49 (G41_RMII_TXD0), U6.17 (TXD0)
RMII_TXD1: SW5.1, U5.36 (G35_BOOT), U5.48 (G35_RMII_TXD1), U6.18 (TXD1)
RMII_TXEN: U5.50 (G33_RMII_TXEN), U6.16 (TXEN)
TP_SCL: J6.11, R33.2, U5.6 (LPG9_SCL)
TP_SDA: J6.12, R34.2, U5.4 (LPG11_SDA)

Notes on the sheet:
M5Stack Stamp-P4 (ESP32-P4, 16 MB Flash, 32 MB PSRAM)
Modul wird aufgelötet (RMII + DSI nur an den Randpads oben). Eigener USB-C des Moduls = Flash/Konsole P4 → an den Platinenrand setzen.
Bedienung, Link zum S3, Erweiterung
BOOT P4 liegt auf G35 (= RMII_TXD1), nur beim Reset drücken.
Ethernet 10/100 (LAN8720A, 25-MHz-Quarz, REFCLKO 50 MHz → P4)
nINTSEL = 0 (R an LED2) → Pin 14 liefert 50 MHz Referenztakt. PHY-Adresse 0. 4 × 49,9 Ω an ETH_AVDD (gefiltert über FB1), Mittelanzapfungen ebenfalls an ETH_AVDD.
7"-Display (MIPI-DSI 2-Lane, FPC 15-pol. 1,0 mm, Raspberry-Pi-Belegung)
Touch-I²C über FPC (Pin 11/12). Display-Logik 3,3 V über Pin 15, Hintergrundbeleuchtung 5 V separat. DSI-Paare 100 Ω differentiell, so kurz wie möglich.
Befestigung
