NordOtto/Pumpensteuerung/hardware/kicad/io.kicad_sch

## KiCad design hardware/kicad/io.kicad_sch (2026-10-20)

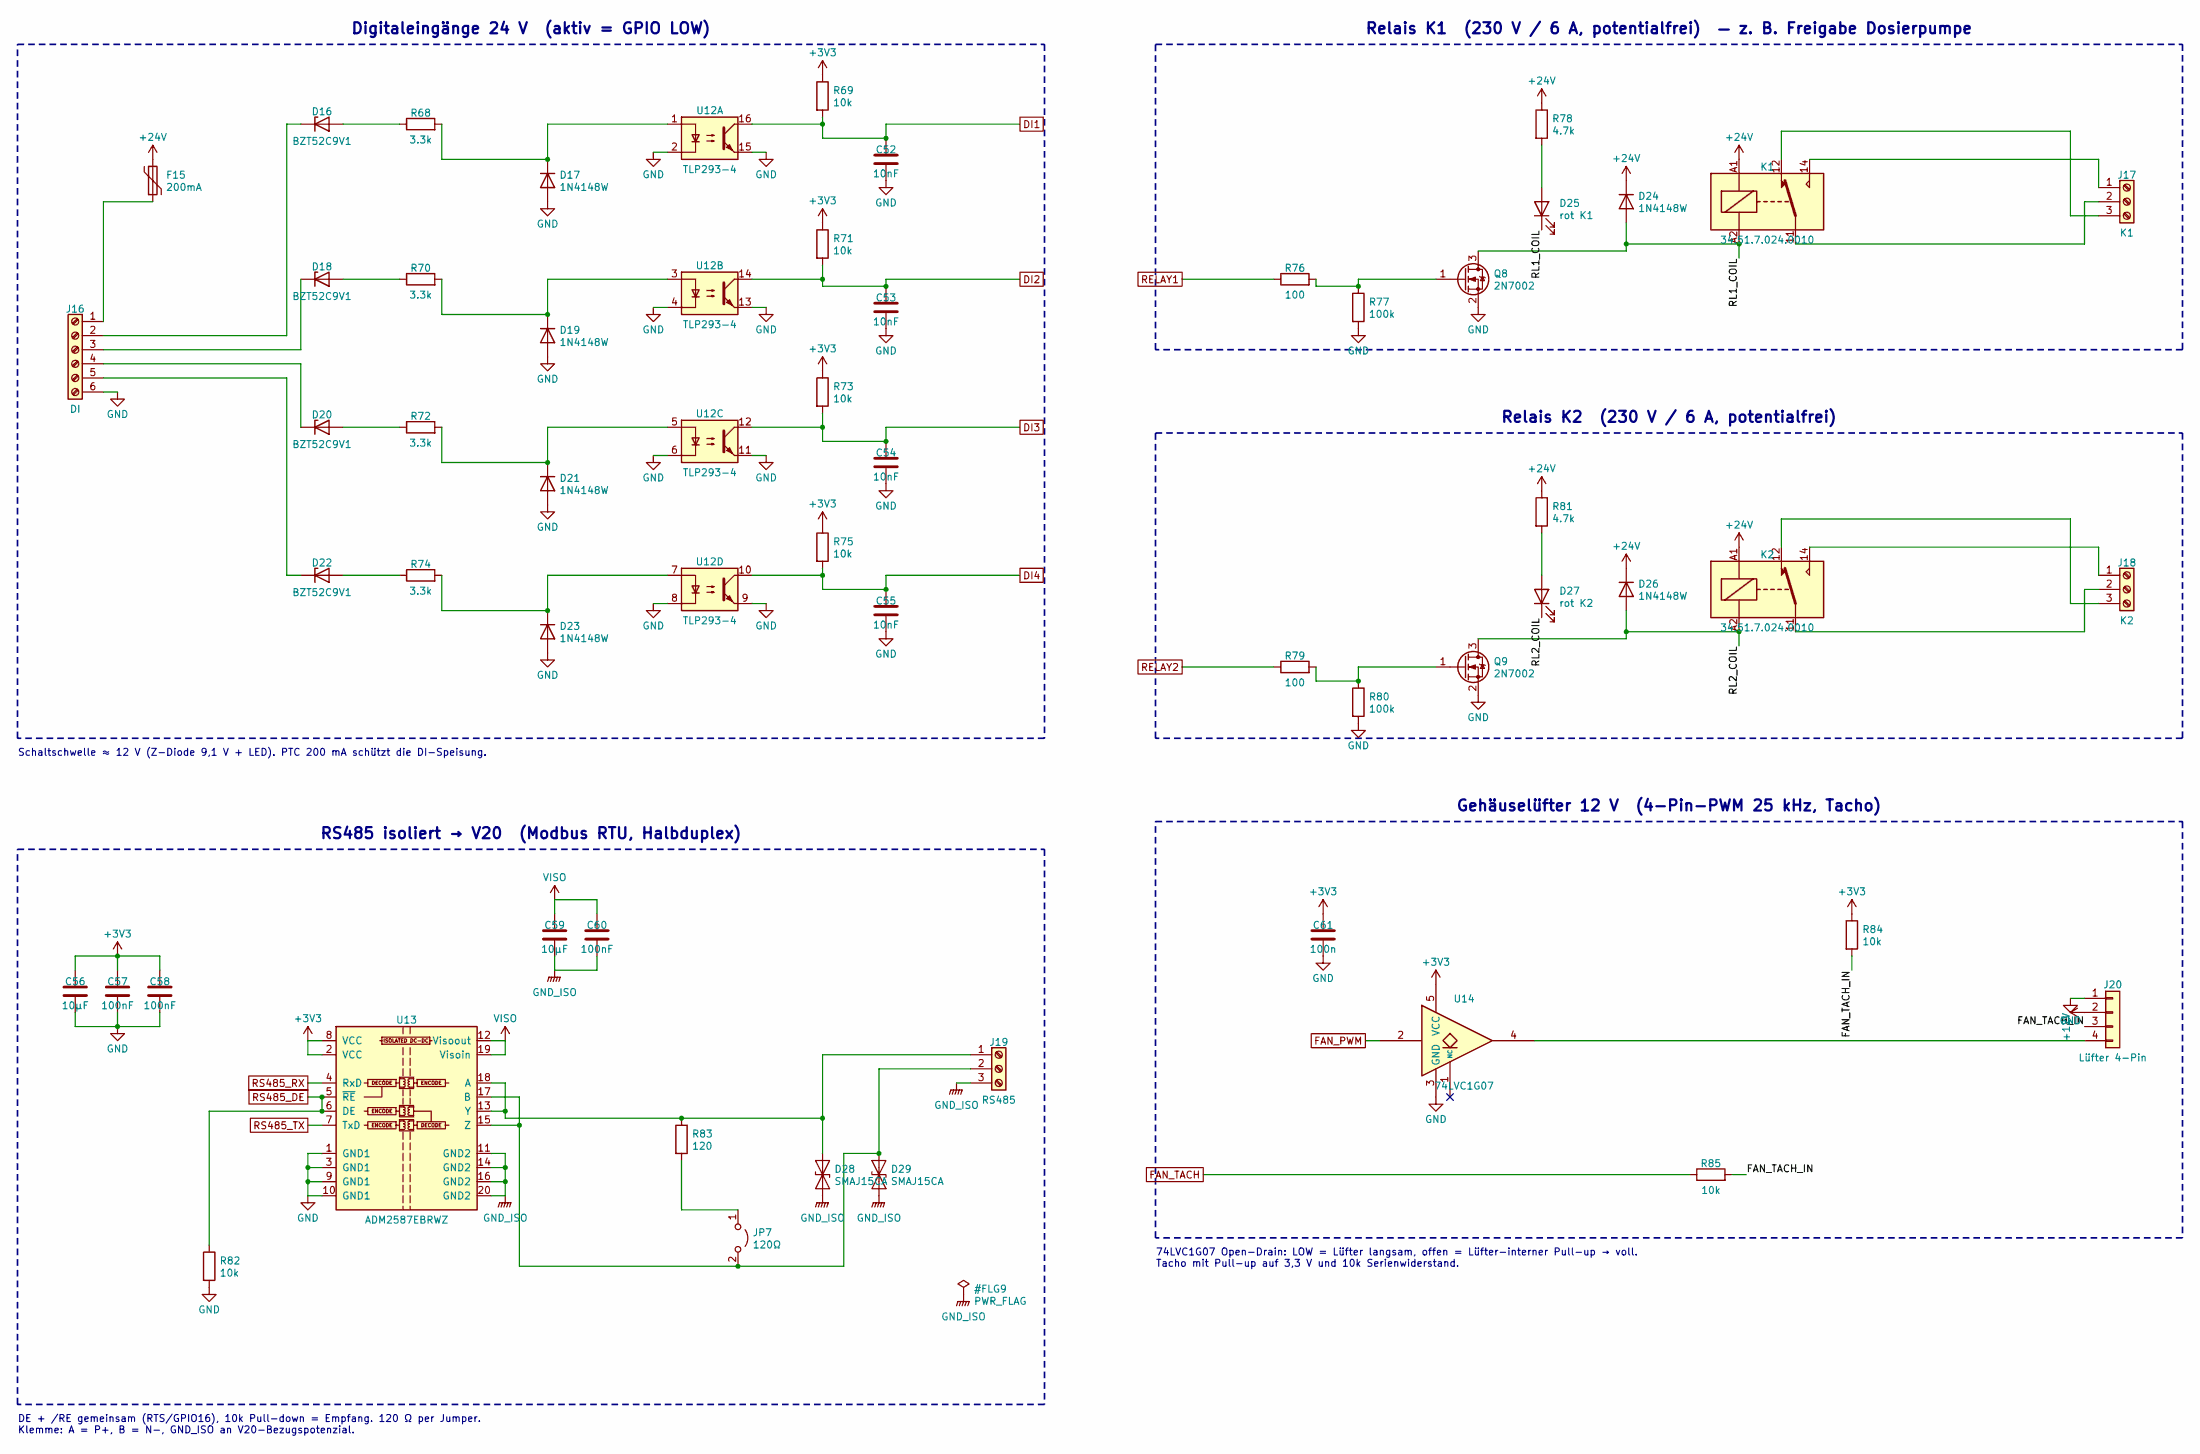
[picture p8: schematic io.kicad_sch]

Parts:
C52, C53, C54, C55: 10nF; C_0603_1608Metric
C56, C59: 10µF; C_0805_2012Metric
C57, C58, C60: 100nF; C_0603_1608Metric
C61: 100n; C_0603_1608Metric
D16, D18, D20, D22: BZT52C9V1; D_SOD-123
D17, D19, D21, D23, D24, D26: 1N4148W; D_SOD-123
D25: rot K1; LED_0603_1608Metric
D27: rot K2; LED_0603_1608Metric
D28, D29: SMAJ15CA; D_SMA
F15: 200mA; Fuse_1206_3216Metric; MPN Bourns MF-USMF020-2
J16: DI; TerminalBlock_Phoenix_PT-1,5-6-3.5-H_1x06_P3.50mm_Horizontal
J17: K1; TerminalBlock_Phoenix_MKDS-1,5-3-5.08_1x03_P5.08mm_Horizont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
J18: K2; TerminalBlock_Phoenix_MKDS-1,5-3-5.08_1x03_P5.08mm_Horizont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
J19: RS485; TerminalBlock_Phoenix_PT-1,5-3-3.5-H_1x03_P3.50mm_Horizontal
J20: Lüfter 4-Pin; FanPinHeader_1x04_P2.54mm_Vertical
JP7: 120Ω; PinHeader_1x02_P2.54mm_Vertical
K1, K2: 34.51.7.024.0010; Relay_SPDT_Finder_34.51_Vertical; MPN Finder 34.51.7.024.0010
Q8, Q9: 2N7002; SOT-23
R68, R70, R72, R74: 3.3k; R_1206_3216Metric
R69, R71, R73, R75, R82, R84, R85: 10k; R_0603_1608Metric
R76, R79: 100; R_0603_1608Metric
R77, R80: 100k; R_0603_1608Metric
R78, R81: 4.7k; R_0603_1608Metric
R83: 120; R_1206_3216Metric
U12: TLP293-4; SOIC-16_4.55x10.3mm_P1.27mm
U13: ADM2587EBRWZ; SOIC-20W_7.5x12.8mm_P1.27mm
U14: 74LVC1G07; SOT-23-5

Connections:
+3V3: C56.1, C57.1, C58.1, C61.1, R69.1, R71.1, R73.1, R75.1, R84.1, U13.2 (VCC), U13.8 (VCC), U14.5 (VCC)
+12V: J20.2
+24V: D24.1 (K), D26.1 (K), F15.1, K1.A1, K2.A1, R78.1, R81.1
DI1: C52.1, R69.2, U12.16
DI2: C53.1, R71.2, U12.14
DI3: C54.1, R73.2, U12.12
DI4: C55.1, R75.2, U12.10
FAN_PWM: U14.2
FAN_TACH: R85.1
FAN_TACH_IN: J20.3, R84.2, R85.2
GND: C52.2, C53.2, C54.2, C55.2, C56.2, C57.2, C58.2, C61.2, D17.2 (A), D19.2 (A), D21.2 (A), D23.2 (A), J16.6, J20.1, Q8.2 (S), Q9.2 (S), R77.2, R80.2, R82.2, U12.2, U12.4, U12.6, U12.8, U12.9, U12.11, U12.13, U12.15, U13.1 (GND1), U13.3 (GND1), U13.9 (GND1), U13.10 (GND1), U14.3 (GND)
GND_ISO: C59.2, C60.2, D28.2 (A2), D29.2 (A2), J19.3, U13.11 (GND2), U13.14 (GND2), U13.16 (GND2), U13.20 (GND2)
unnamed: D16.1 (K), J16.2
unnamed: D16.2 (A), R68.1
unnamed: D17.1 (K), R68.2, U12.1
unnamed: D18.1 (K), J16.3
unnamed: D18.2 (A), R70.1
unnamed: D19.1 (K), R70.2, U12.3
unnamed: D20.1 (K), J16.4
unnamed: D20.2 (A), R72.1
unnamed: D21.1 (K), R72.2, U12.5
unnamed: D22.1 (K), J16.5
unnamed: D22.2 (A), R74.1
unnamed: D23.1 (K), R74.2, U12.7
unnamed: D25.2 (A), R78.2
unnamed: D27.2 (A), R81.2
unnamed: D28.1 (A1), J19.1, R83.1, U13.13 (Y), U13.18 (A)
unnamed: D29.1 (A1), J19.2, JP7.2 (B), U13.15 (Z), U13.17 (B)
unnamed: F15.2, J16.1
unnamed: J17.1, K1.14
unnamed: J17.2, K1.11
unnamed: J17.3, K1.12
unnamed: J18.1, K2.14
unnamed: J18.2, K2.11
unnamed: J18.3, K2.12
unnamed: J20.4, U14.4
unnamed: JP7.1 (A), R83.2
unnamed: Q8.1 (G), R76.2, R77.1
unnamed: Q9.1 (G), R79.2, R80.1
RELAY1: R76.1
RELAY2: R79.1
RL1_COIL: D24.2 (A), D25.1 (K), K1.A2, Q8.3 (D)
RL2_COIL: D26.2 (A), D27.1 (K), K2.A2, Q9.3 (D)
RS485_DE: R82.1, U13.5 (~RE), U13.6 (DE)
RS485_RX: U13.4 (RxD)
RS485_TX: U13.7 (TxD)
VISO: C59.1, C60.1, U13.12 (Visoout), U13.19 (Visoin)

Notes on the sheet:
Digitaleingänge 24 V (aktiv = GPIO LOW)
Schaltschwelle ≈ 12 V (Z-Diode 9,1 V + LED). PTC 200 mA schützt die DI-Speisung.
Relais K1 (230 V / 6 A, potentialfrei) — z. B. Freigabe Dosierpumpe
Relais K2 (230 V / 6 A, potentialfrei)
RS485 isoliert → V20 (Modbus RTU, Halbduplex)
DE + /RE gemeinsam (RTS/GPIO16), 10k Pull-down = Empfang. 120 Ω per Jumper. Klemme: A = P+, B = N−, GND_ISO an V20-Bezugspotenzial.
Gehäuselüfter 12 V (4-Pin-PWM 25 kHz, Tacho)
74LVC1G07 Open-Drain: LOW = Lüfter langsam, offen = Lüfter-interner Pull-up → voll. Tacho mit Pull-up auf 3,3 V und 10k Serienwiderstand.
