NordOtto/Pumpensteuerung/hardware/kicad/power.kicad_sch

## KiCad design hardware/kicad/power.kicad_sch (2026-10-20)

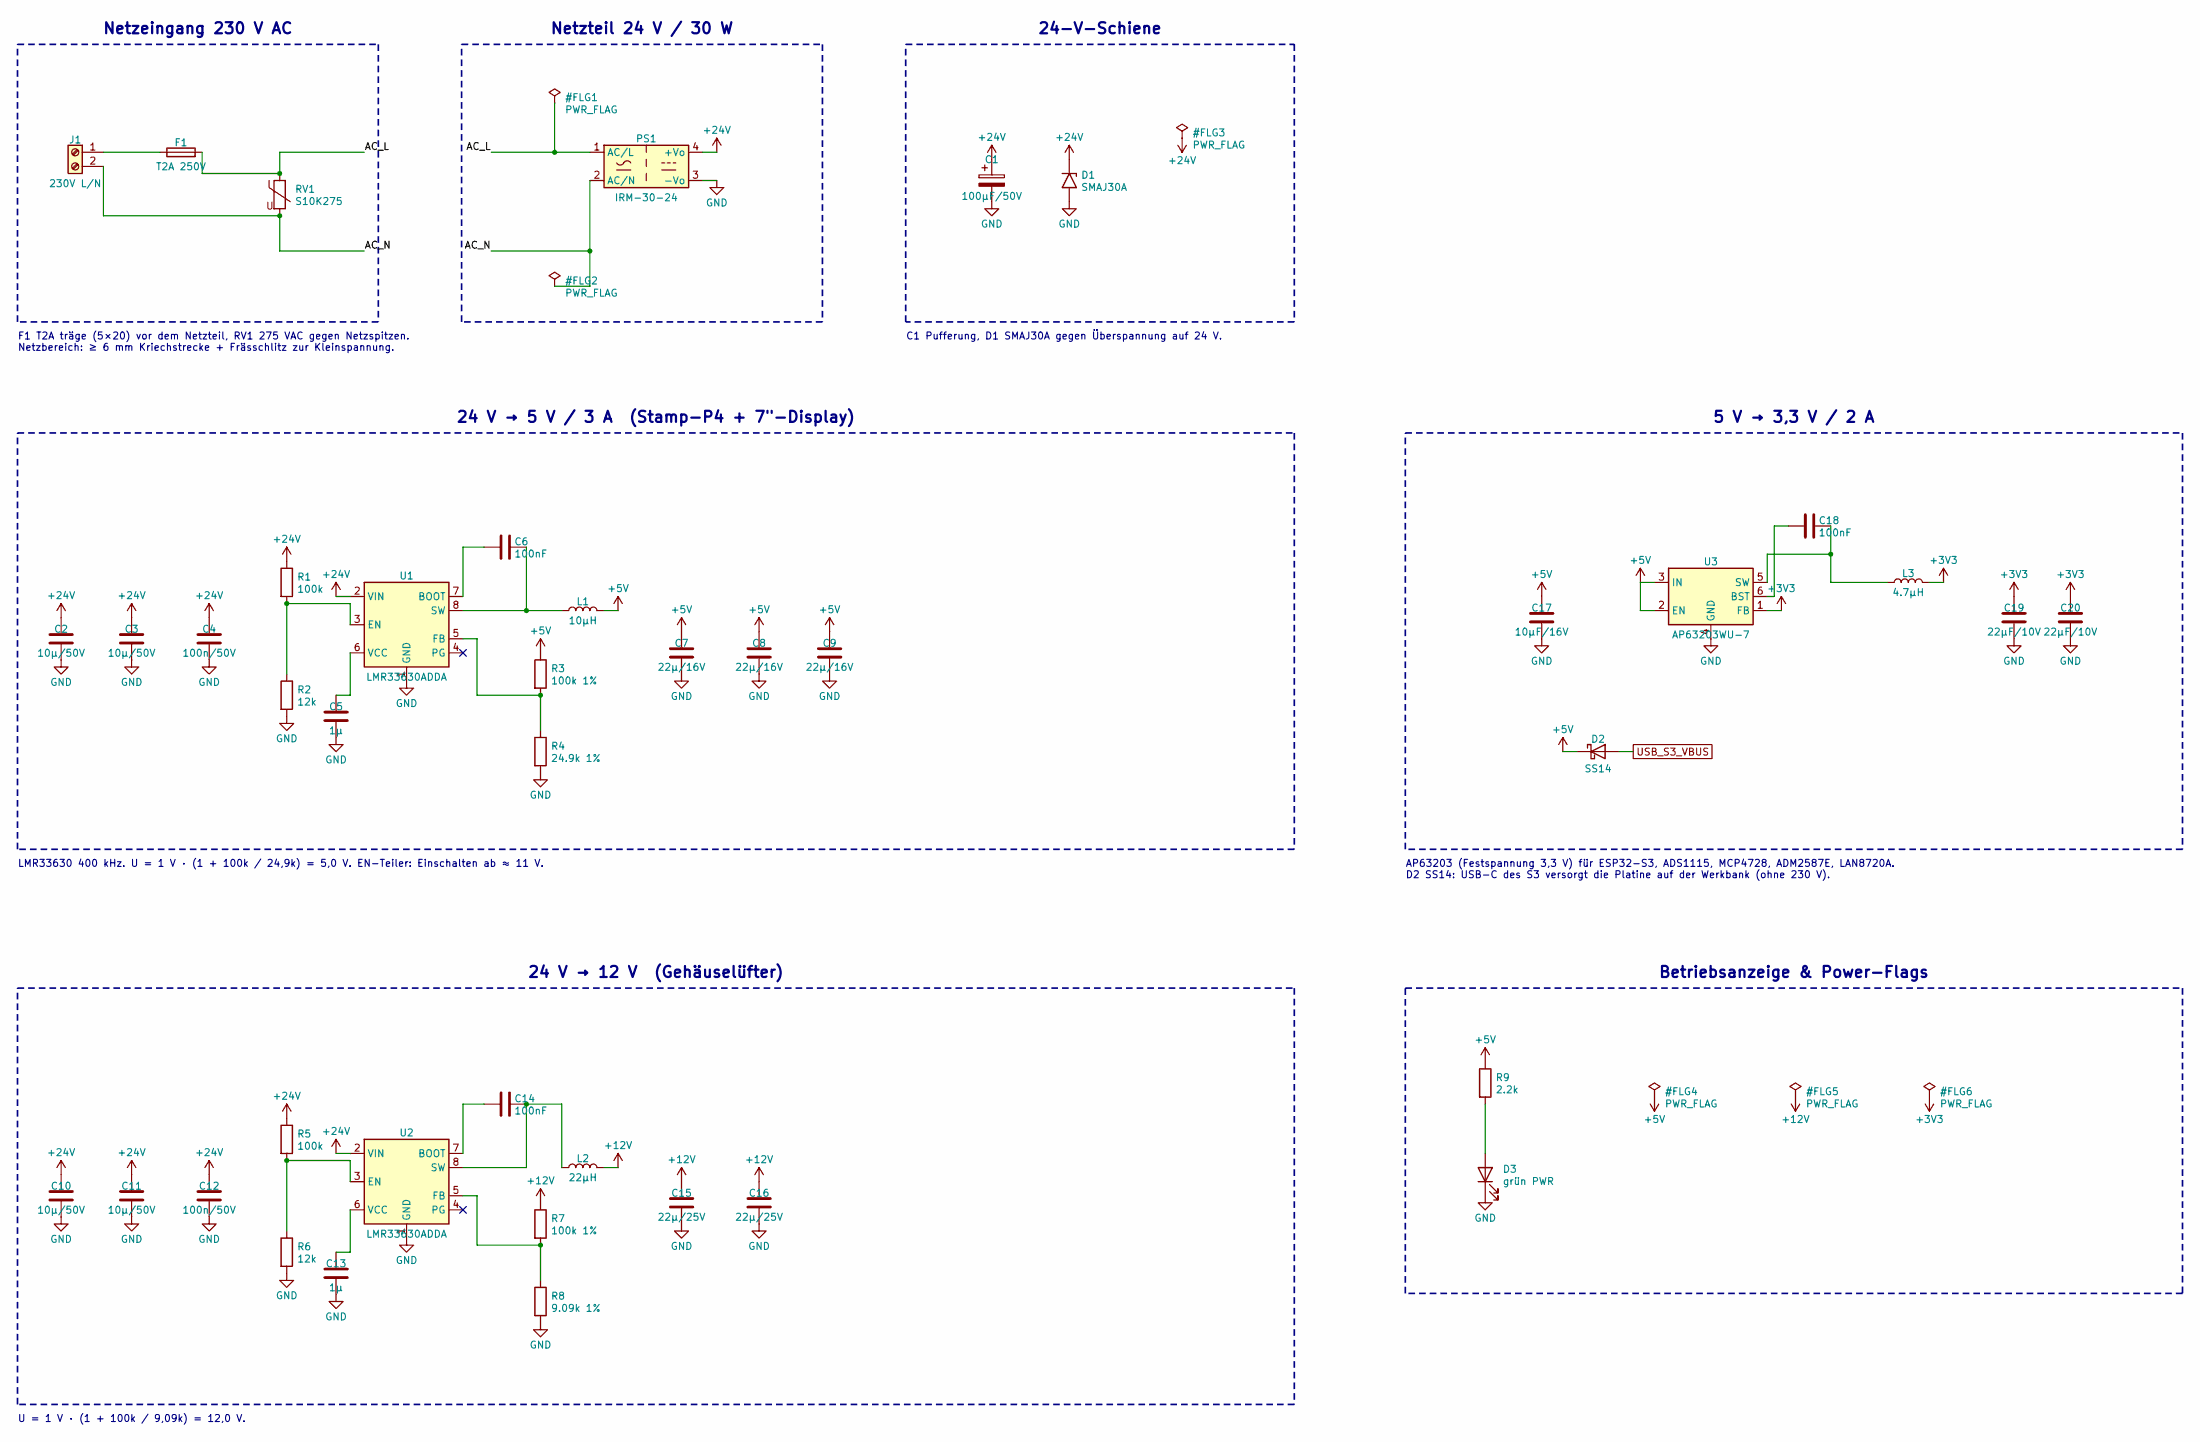
[picture p9: schematic power.kicad_sch]

Parts:
C1: 100µF/50V; CP_Elec_10x10.5
C2, C3, C10, C11: 10µ/50V; C_1210_3225Metric
C4, C12: 100n/50V; C_0603_1608Metric
C5, C13: 1µ; C_0603_1608Metric
C6, C14, C18: 100nF; C_0603_1608Metric
C7, C8, C9: 22µ/16V; C_1210_3225Metric
C15, C16: 22µ/25V; C_1210_3225Metric
C17: 10µF/16V; C_0805_2012Metric
C19, C20: 22µF/10V; C_1210_3225Metric
D1: SMAJ30A; D_SMA
D2: SS14; D_SMA
D3: grün PWR; LED_0603_1608Metric
F1: T2A 250V; Fuseholder_Clip-5x20mm_Keystone_3517_Inline_P23.11x6.76mm_D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
J1: 230V L/N; TerminalBlock_Phoenix_MKDS-1,5-2-5.08_1x02_P5.08mm_Horizont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
L1: 10µH; L_Bourns_SRP7028A_7.3x6.6mm; MPN Bourns SRP7028A-100M
L2: 22µH; L_Bourns_SRP7028A_7.3x6.6mm; MPN Bourns SRP7028A-220M
L3: 4.7µH; L_Bourns-SRN6028; MPN Bourns SRN6028-4R7M
PS1: IRM-30-24; MeanWell_IRM-30; MPN Mean Well IRM-30-24
R1, R5: 100k; R_0603_1608Metric
R2, R6: 12k; R_0603_1608Metric
R3, R7: 100k 1%; R_0603_1608Metric
R4: 24.9k 1%; R_0603_1608Metric
R8: 9.09k 1%; R_0603_1608Metric
R9: 2.2k; R_0603_1608Metric
RV1: S10K275; RV_Disc_D12mm_W4.2mm_P7.5mm
U1, U2: LMR33630ADDA; Texas_HSOP-8-1EP_3.9x4.9mm_P1.27mm_ThermalVias; MPN LMR33630ADDAR
U3: AP63203WU-7; TSOT-23-6; MPN AP63203WU-7

Connections:
+3V3: C19.1, C20.1, L3.2, U3.1 (FB)
+5V: C7.1, C8.1, C9.1, C17.1, D2.1 (K), L1.2, R3.1, R9.1, U3.2 (EN), U3.3 (IN)
+12V: C15.1, C16.1, L2.2, R7.1
+24V: C1.1, C2.1, C3.1, C4.1, C10.1, C11.1, C12.1, D1.1 (A1), PS1.4 (+Vo), R1.1, R5.1, U1.2 (VIN), U2.2 (VIN)
AC_L: F1.2, PS1.1 (AC/L), RV1.1
AC_N: J1.2, PS1.2 (AC/N), RV1.2
GND: C1.2, C2.2, C3.2, C4.2, C5.2, C7.2, C8.2, C9.2, C10.2, C11.2, C12.2, C13.2, C15.2, C16.2, C17.2, C19.2, C20.2, D1.2 (A2), D3.1 (K), PS1.3 (-Vo), R2.2, R4.2, R6.2, R8.2, U1.1 (GND), U1.9 (GND), U2.1 (GND), U2.9 (GND), U3.4 (GND)
unnamed: C5.1, U1.6 (VCC)
unnamed: C6.1, U1.7 (BOOT)
unnamed: C6.2, L1.1, U1.8 (SW)
unnamed: C13.1, U2.6 (VCC)
unnamed: C14.1, U2.7 (BOOT)
unnamed: C14.2, L2.1, U2.8 (SW)
unnamed: C18.1, U3.6 (BST)
unnamed: C18.2, L3.1, U3.5 (SW)
unnamed: D3.2 (A), R9.2
unnamed: F1.1, J1.1
unnamed: R1.2, R2.1, U1.3 (EN)
unnamed: R3.2, R4.1, U1.5 (FB)
unnamed: R5.2, R6.1, U2.3 (EN)
unnamed: R7.2, R8.1, U2.5 (FB)
USB_S3_VBUS: D2.2 (A)

Notes on the sheet:
Netzeingang 230 V AC
F1 T2A träge (5×20) vor dem Netzteil, RV1 275 VAC gegen Netzspitzen. Netzbereich: ≥ 6 mm Kriechstrecke + Frässchlitz zur Kleinspannung.
Netzteil 24 V / 30 W
24-V-Schiene
C1 Pufferung, D1 SMAJ30A gegen Überspannung auf 24 V.
24 V → 5 V / 3 A (Stamp-P4 + 7"-Display)
LMR33630 400 kHz. U = 1 V · (1 + 100k / 24,9k) = 5,0 V. EN-Teiler: Einschalten ab ≈ 11 V.
24 V → 12 V (Gehäuselüfter)
U = 1 V · (1 + 100k / 9,09k) = 12,0 V.
5 V → 3,3 V / 2 A
AP63203 (Festspannung 3,3 V) für ESP32-S3, ADS1115, MCP4728, ADM2587E, LAN8720A. D2 SS14: USB-C des S3 versorgt die Platine auf der Werkbank (ohne 230 V).
Betriebsanzeige & Power-Flags
