NordOtto/Pumpensteuerung/hardware/tools/cm5_pins.py

"""Pinbelegung der beiden 100-poligen CM5-Steckverbinder (Raspberry Pi CM5 Datasheet, Tabelle 4).

Stecker A = CM5-Pins 1–100, Stecker B = CM5-Pins 101–200 (auf dem Footprint B als Pad 1–100).
Vor dem Layout gegen das aktuelle Datenblatt RP-008180-DS gegenprüfen.
"""
_A = """1 GND|2 GND|3 Ethernet_Pair3_P|4 Ethernet_Pair1_P|5 Ethernet_Pair3_N|6 Ethernet_Pair1_N|7 GND|8 GND|
9 Ethernet_Pair2_N|10 Ethernet_Pair0_N|11 Ethernet_Pair2_P|12 Ethernet_Pair0_P|13 GND|14 GND|15 Ethernet_nLED3|
16 Fan_Tacho|17 Ethernet_nLED2|18 Ethernet_SYNC_OUT|19 Fan_PWM|20 EEPROM_nWP|21 LED_nACT|22 GND|23 GND|24 GPIO26|
25 GPIO21|26 GPIO19|27 GPIO20|28 GPIO13|29 GPIO16|30 GPIO6|31 GPIO12|32 GND|33 GND|34 GPIO5|35 ID_SC|36 ID_SD|
37 GPIO7|38 GPIO11|39 GPIO8|40 GPIO9|41 GPIO25|42 GND|43 GND|44 GPIO10|45 GPIO24|46 GPIO22|47 GPIO23|48 GPIO27|
49 GPIO18|50 GPIO17|51 GPIO15|52 GND|53 GND|54 GPIO4|55 GPIO14|56 GPIO3|57 SD_CLK|58 GPIO2|59 GND|60 GND|
61 SD_DAT3|62 SD_CMD|63 SD_DAT0|64 SD_DAT5|65 GND|66 GND|67 SD_DAT1|68 SD_DAT4|69 SD_DAT2|70 SD_DAT7|71 GND|
72 SD_DAT6|73 SD_VDD_OVERRIDE|74 GND|75 SD_PWR_ON|76 VBAT|77 +5V_IN|78 GPIO_VREF|79 +5V_IN|80 SCL0|81 +5V_IN|
82 SDA0|83 +5V_IN|84 CM5_3V3|85 +5V_IN|86 CM5_3V3|87 +5V_IN|88 CM5_1V8|89 WL_nDisable|90 CM5_1V8|
91 BT_nDisable|92 PWR_Button|93 nRPIBOOT|94 CC1|95 LED_nPWR|96 CC2|97 CAM_GPIO0|98 GND|99 PMIC_Enable|100 CAM_GPIO1"""

_B = """101 USB_OTG_ID|102 PCIe_CLK_nREQ|103 USB_N|104 PCIE_nWAKE|105 USB_P|106 PCIE_PWR_EN|107 GND|108 GND|
109 PCIe_nRST|110 PCIe_CLK_P|111 VBUS_EN|112 PCIe_CLK_N|113 GND|114 GND|115 MIPI0_D0_N|116 PCIe_RX_P|
117 MIPI0_D0_P|118 PCIe_RX_N|119 GND|120 GND|121 MIPI0_D1_N|122 PCIe_TX_P|123 MIPI0_D1_P|124 PCIe_TX_N|125 GND|
126 GND|127 MIPI0_C_N|128 USB3-0-RX_N|129 MIPI0_C_P|130 USB3-0-RX_P|131 GND|132 GND|133 MIPI0_D2_N|
134 USB3-0-DP|135 MIPI0_D2_P|136 USB3-0-DM|137 GND|138 GND|139 MIPI0_D3_N|140 USB3-0-TX_N|141 MIPI0_D3_P|
142 USB3-0-TX_P|143 HDMI1_HOTPLUG|144 GND|145 HDMI1_SDA|146 HDMI1_TX2_P|147 HDMI1_SCL|148 HDMI1_TX2_N|
149 HDMI1_CEC|150 GND|151 HDMI0_CEC|152 HDMI1_TX1_P|153 HDMI0_HOTPLUG|154 HDMI1_TX1_N|155 GND|156 GND|
157 USB3-1-RX_N|158 HDMI1_TX0_P|159 USB3-1-RX_P|160 HDMI1_TX0_N|161 GND|162 GND|163 USB3-1-DP|164 HDMI1_CLK_P|
165 USB3-1-DM|166 HDMI1_CLK_N|167 GND|168 GND|169 USB3-1-TX_N|170 HDMI0_TX2_P|171 USB3-1-TX_P|172 HDMI0_TX2_N|
173 GND|174 GND|175 MIPI1_D0_N|176 HDMI0_TX1_P|177 MIPI1_D0_P|178 HDMI0_TX1_N|179 GND|180 GND|181 MIPI1_D1_N|
182 HDMI0_TX0_P|183 MIPI1_D1_P|184 HDMI0_TX0_N|185 GND|186 GND|187 MIPI1_C_N|188 HDMI0_CLK_P|189 MIPI1_C_P|
190 HDMI0_CLK_N|191 GND|192 GND|193 MIPI1_D2_N|194 MIPI1_D3_N|195 MIPI1_D2_P|196 MIPI1_D3_P|197 GND|198 GND|
199 HDMI0_SDA|200 HDMI0_SCL"""


def _parse(s):
    out = {}
    for tok in s.replace("\n", "").split("|"):
        n, name = tok.strip().split(" ", 1)
        out[int(n)] = name
    return out


CM5_A = _parse(_A)                                  # Pad 1..100
CM5_B = {k - 100: v for k, v in _parse(_B).items()}  # Pad 1..100 = CM5-Pin 101..200
assert sorted(CM5_A) == list(range(1, 101)) and sorted(CM5_B) == list(range(1, 101))


def ptypes(table):
    t = {}
    for n, name in table.items():
        if name == "GND" or name == "+5V_IN":
            t[n] = "power_in"
        elif name == "CM5_3V3" and n == 84:
            t[n] = "power_out"
        else:
            t[n] = "passive"
    return t


def gpio_pad(gpio: int) -> int:
    """Pad-Nummer auf Stecker A für BCM-GPIO n."""
    for n, name in CM5_A.items():
        if name == f"GPIO{gpio}":
            return n
    raise KeyError(gpio)
