NordOtto/Pumpensteuerung/(commit log)

2026-03-28 Initial commit: ESP32 hardware bridge + Docker backend
    [partitions.csv]
2026-03-28 CI/CD: GitHub Actions workflow für Docker Build + Push hinzugefügt
    Workflow baut bei jedem Push auf main die Backend- und Nginx-Images
    und pusht sie nach ghcr.io/nordotto. docker-compose und docker-stack
    referenzieren jetzt die ghcr.io-Images statt lokaler Builds.
2026-03-28 test: Watchtower-Test – Build-Timestamp im Startlog
2026-03-29 feat: PWA Service Worker + Theme Toggle (Dark/Light)
    - icon.svg als App-Icon erstellt
    - sw.js: Service Worker mit Cache-Strategie für Offline-Support
    - manifest.json: SVG-Icon mit 'any' size
    - index.html: Theme-Toggle-Button im Header, Light/Dark CSS, SW-Registrierung
2026-03-29 feat(ui): modernize dashboard to professional HMI design
    Rewrite index.html with SVG circular gauges (frequency, temperature,
    pressure), sticky KPI header bar, sparkline trend charts, toast
    notifications, segmented controls, and glassmorphism cards.
    All existing functionality preserved (WebSocket, API, drag&drop,
    collapse, presets, timeguard, PI control). Bump sw.js cache to v3.
2026-03-29 feat(ui): redesign dashboard to industrial HMI aesthetic
    Replace glassmorphism with flat matte panels, sharp 4px corners,
    larger gauges (190px, 12px stroke), trend charts with grid lines,
    uppercase industrial buttons, and tighter tile-based grid layout.
2026-03-30 fix: Sicherheitsfunktion (Trockenlauf/No-demand) repariert + Urlaubsmodus
    Sicherheits-Bug: Flow-Schätzung (effectiveFlow) deaktivierte beide
    Safety-Checks da sie bei laufender Pumpe immer >= 1.0 L/min war.
    Safety-Checks verwenden jetzt den echten Sensorwert (flow).
    Neu: Urlaubsmodus / Außer-Haus-Sperre
    - Pumpe wird sofort gestoppt und gesperrt wenn aktiv
    - Persistiert in pressure_ctrl.json (überlebt Neustarts)
    - REST: GET/POST /api/vacation
    - MQTT: pumpensteuerung/vacation/set + vacation/state
    - WebSocket + Frontend: Banner + Toggle-Button im V20-Card
2026-03-30 feat: HMI-Style UI Redesign (SCADA-Layout)
    - 3-Spalten-Layout: SVG-Prozessschema links, Echtzeit-Chart Mitte, KPI-Panel rechts
    - SVG-Schematic mit Live-Sensor-Werten (Druck, Durchfluss, Temperaturen, Frequenz, Lüfter)
    - Rohre animiert (blau/dash) wenn Pumpe läuft
    - 30-Min-SVG-Chart für Druck, Frequenz und Durchfluss mit Crosshair/Tooltip
    - KPI-Rechts-Panel: Elektrik, Pumpe, Druck/Durchfluss, System
    - Bottom-Nav: Übersicht / Einstellungen / Presets / Protokoll
    - Alle Einstellungen (PI, Zeitsperre, Lüfter, Presets, Urlaubsmodus) in Einstellungen-Seite
2026-03-30 feat: Settings-Seite mit Sidebar-Navigation statt 3-col Grid
    - Linke Sidebar mit 5 Tabs: PI-Regelung, Zeitsperre, Lüfter, Presets, Urlaubsmodus
    - Jeder Tab zeigt nur sein Panel (übersichtlich, nicht alles auf einmal)
    - Bottom-Nav Presets-Tab navigiert direkt zu Settings > Presets
    - Aktiver Settings-Tab wird in localStorage gespeichert
    - Besseres Spacing und Abschnitts-Header in den Panels
2026-03-31 fix: Urlaubsmodus-Banner überdeckt nicht mehr den Seiteninhalt\n\n- Grid-Layout: Alle 3 Pages (overview/settings/log) teilen sich\n dieselbe Grid-Row (row 3), Bottom-Nav explizit in Row 4\n- Banner-I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
2026-04-06 feat(ui): redesign dashboard mobile-first HMI (Tesla-Style)
    Komplettes Frontend-Redesign: monolithische 1.5k-Zeilen index.html
    ersetzt durch saubere index.html + styles.css + app.js. Tailwind-CDN
    und GSAP entfernt, eigenes CSS mit strict 5-Farben-Palette, Light/Dark
    Theme, responsive 1/2/4 Spalten KPI-Grid, große Touch-Buttons,
    Settings-Drawer und SVG-Verlaufschart. Backend/REST/WS unverändert.
2026-04-06 fix(ui): readable inputs in dark mode + light theme default + robust settings load
    - Eigene --input-bg Variable, im Dark-Mode deutlich heller als Tile,
    dadurch sind Eingabefelder sichtbar und fokussierbar
    - Light-Theme als Default (statt Auto), Toggle-Reihenfolge light → dark → auto
    - loadSettings: setVal() Helper, Fallback auf lastState wenn REST scheitert,
    Konsolen-Warnung bei fehlerhaften GETs
    - Page-Hintergrund leicht gegen Tiles abgesetzt (#f4f6f8) für klarere Tile-Optik
2026-04-06 fix(pwa): self-destruct service worker to flush stale cache
    Alte SW-Versionen (pumpe-v3/v5) haben das veraltete Dashboard-Markup
    ausgeliefert, sodass das neue UI nur kurz aufblitzte und sofort wieder
    durch den SW-Cache überschrieben wurde. sw.js löscht jetzt alle Caches,
    deregistriert sich selbst und lädt offene Clients neu. app.js
    deregistriert zusätzlich client-seitig alle vorhandenen SWs und leert
    caches.keys() — damit auch Browser ohne neuen SW-Hit gesäubert werden.
2026-04-06 fix(pwa): remove client.navigate() from sw.js to stop reload loop
    Der Self-Destruct-SW hat nach activate alle Clients per c.navigate(c.url)
    neu geladen. Der Reload installiert den SW erneut, der wieder navigiert —
    Endlos-Reload-Loop, das neue UI war nur im Bruchteil zwischen zwei Reloads
    sichtbar. Caches löschen + unregister bleibt; der nächste manuelle Reload
    zeigt die saubere Seite.
2026-04-06 feat(frontend): UI redesign - Wilo/eco industrial style
    - Dark navy header with status icons + clock (removed title/operator)
    - Two-panel layout: info+KPIs left, chart right
    - KPIs integrated into left panel as 2x2 grid
    - Controls (Start/Stop/Reset + freq slider) moved to fixed bottom toolbar
    - Bottom toolbar with quick-access buttons (Fan/Presets/Settings)
    - Full responsive: phone/tablet/desktop breakpoints
    - Safe area support for notched phones
    - Drawer header restyled with navy background
2026-04-06 feat(ui): Dark glassmorphism redesign with light/dark toggle
    - Complete UI rewrite: skeuomorphic display, glass cards, wave patterns
    - Material Symbols icons (replaces Lucide)
    - Light/Dark toggle with localStorage persistence
    - Status dots with glow effects for MQTT/Modbus/Pump
    - 3D skeuomorphic Start/Stop/Reset buttons
    - Hardware details in clean 2-column table layout
    - Responsive design (mobile bottom nav, drawer settings)
    - Chart.js with dark/light theme switching
    - All backend API mappings verified (v20, pressure, presets, fan)
2026-04-06 feat: sidebar nav drag-drop reorder, status pills, preset edit, chart fix, UI polish
    - Sidebar nav buttons draggable (desktop + touch), order saved in localStorage
    - Status pills on main display: Zeitsperre (Erlaubt/Gesperrt), PI (active + setpoint)
    - Preset edit button, compact icon layout, error feedback on delete
    - Chart Y-axis max 10 → 6 bar
    - lang=en for dot decimal separator
    - Hide number input spinners, force custom font on form elements
    - Detailed WebSocket logging per message
    - Grab cursor on draggable nav buttons
2026-04-06 feat: SSL CA trust, pro buttons, new KPI cards, HW details overhaul
    SSL/PWA:
    - CA + server cert workflow (entrypoint creates local CA, signs server cert)
    - All container IPs auto-added to SAN
    - /ca.pem download endpoint for smartphone trust install
    - After trusting CA: green padlock + PWA install works
    UI - Control Bar:
    - Professional gradient buttons with icons (Start/Stop/Reset)
    - Removed status dots (MQTT/Modbus/Pump) from main card (info in System Status)
    UI - KPI Cards (5 cards):
    - Renamed Fluss → Durchfluss
    - Replaced Ist-Freq + Status with: Wasser Temp, Gehäuse Temp, Lüfter RPM
    - Contextual sub-labels (Kalt/Normal/Warm, Automatik/Manuell)
    UI - Hardware Details:
    - Removed Water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
2026-04-06 fix: force dot decimal, HW details cleanup, power in W, backdrop close
    - Intercept comma key in number inputs → replace with dot
    - lang=en-US on html element
    - Removed Ist-Freq + Sollfrequenz from Hardware Details (already in main card)
    - Power display in Watt instead of kW
    - Sidebar closes on backdrop click (not just X button)
2026-04-06 feat: dual HTTP+HTTPS nginx for reverse proxy support
    - Port 80: HTTP server for behind reverse proxy (NPM/Traefik terminates SSL)
    - Port 443: HTTPS with self-signed cert for direct LAN access
    - No more HTTP→HTTPS redirect (breaks reverse proxy flow)
    - WebSocket upgrade via map directive
2026-04-06 feat: token-based authentication with auto-login
    - Backend: auth.js with HMAC tokens, requireAuth middleware, WS upgrade check
    - Frontend: glassmorphism login overlay, authFetch helper, localStorage token
    - Auto-login: stored token validated on page load, 401 triggers logout
    - ENV: AUTH_USER/AUTH_PASS (default: admin/pumpe)
2026-04-06 feat: page zoom setting + header mobile fix
    - New 'Anzeige' tab in sidebar with zoom slider (70%-120%)
    - Zoom persisted in localStorage, applied via CSS zoom
    - Header buttons smaller on mobile (w-8 h-8), flex-wrap to prevent overflow
    - Clock/buttons gap reduced on small screens
2026-04-06 refactor: clean header, move theme to Display tab
    - Removed title, subtitle, clock from header
    - Header now only: gear + logout (right-aligned)
    - Display tab: Dark Mode toggle + Zoom slider
    - Theme toggle syncs with stored preference
2026-04-06 feat: premium UI overhaul — glass, glow, animations
    Background:
    - Radial blue/violet ambient gradients (body::before)
    - Subtle noise texture overlay (body::after)
    Cards (Glass + Neumorphism):
    - Inner shadow (top highlight + bottom depth)
    - Enhanced backdrop-blur-xl
    - Soft outer shadows with hover escalation
    - Staggered fade-in slide-up animation on load
    Buttons (Start/Stop/Reset):
    - Color-matched glow halos (green/red/slate)
    - Hover: stronger glow + translateY(-1px) lift
    - Active: scale(0.98) + inset shadow pressed feel
    - Smooth 0.25s ease transitions
    Typography:
    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
2026-04-07 fix: Zeitsperre wird jetzt in PI-Regler, REST-API und MQTT-Befehlen geprüft
2026-04-08 fix: freq_min/freq_max Obergrenze von 50 auf 60 Hz angehoben
2026-04-08 fix: Frequenz-Slider Bereich auf 30-60 Hz geändert
2026-04-08 fix: Frequenz-API Limit von 50 auf 60 Hz angehoben
2026-04-08 fix: Slider-Wert wird sofort erfasst, WS überschreibt nicht mehr während Send
2026-04-08 fix: Slider Touch-Events für PWA/Mobile, robusterer Event-Flow
2026-04-11 fix: Alle hardcoded 50Hz Limits auf 60Hz (HA Discovery, Presets)
2026-04-11 fix: 50 Hz Hardlimit in ESP32 (mqtt_ha.cpp + modbus_v20.cpp) und Presets auf 60 Hz angehoben
2026-04-17 fix: Trockenlaufschutz weniger aggressiv - Separater Timer fuer Dry-Run (nicht mehr mit No-Demand geteilt) - Erkennungszeit 30s auf 60s erhoeht - 90s Grace-Period nach Pumpenstart und manuellem Reset
2026-04-26 fix: Trockenlaufschutz/No-demand durch echten Sensorwert in Firmware
    Die Firmware ersetzte bei sensor_flow < 1.0 L/min den Rohwert durch eine
    frequenzbasierte Schätzung (z.B. 2.8 L/min bei 35 Hz). Das Backend erhielt
    diesen geschätzten Wert als state.flow_rate, weshalb die Bedingung
    `flow < 1.0` im No-demand-Shutdown und Trockenlaufschutz nie erfüllt wurde –
    der Ausschaltdruck wurde nie erreicht, weil der PI-Regler auf Sollwert regelt.
    Die Schätzung (effectiveFlow) wird korrekt im Backend für den PI-Algorithmus
    berechnet. Die Firmware sendet jetzt immer den rohen Sensorwert.
    https://claude.ai/code/session_01XANEf4vqkkQKmkZbX7Yjgz
2026-04-26 feat: Lokaler Druckschalter-Fallback bei Netzwerkausfall
    Wenn MQTT/Server nach 5s nicht erreichbar ist, übernimmt der ESP32
    die Steuerung autonom – wie ein externer Druckschalter:
    Druck < p_on → Pumpe START (Festfrequenz)
    Druck ≥ p_off → Pumpe STOP
    Bei MQTT-Reconnect übergibt der ESP32 die Kontrolle sofort an
    den PI-Regler im Backend zurück.
    Die Schwellwerte (p_on, p_off, freq) werden vom Backend mit
    retain=true gesendet, im ESP32 in LittleFS gespeichert und
    überleben damit Strom- und Serverausfälle. Standardwerte:
    p_on=2.2 bar, p_off=4.0 bar, freq=50 Hz.
    Neue Dateien: src/fallback_ctrl.h, src/fallback_ctrl.cpp
    Geändert: config.h, main.cpp, mqtt_ha.cpp,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
2026-04-29 feat: Preset mode=2 Fix-Hz, HA Heartbeat-Lock, Stop-Logik, Druckspitzen-Erkennung
    - Neuer Preset-Modus 2 (Fix-Frequenz): PI-Regler wird deaktiviert, V20 laeuft
    auf fester Hz-Zahl; keine PI-Interferenz mehr bei Bewaesserungs-Presets
    - HA Heartbeat/TTL-Lock (presetLock.js): Automation publisht alle 30s Heartbeat,
    nach TTL-Ablauf automatischer Rollback zum vorherigen Preset; Trockenlauf-Sperre
    wird beim Lock-Aktivieren automatisch geloest
    - Stop-Logik gehaertet: Min-Freq-Timeout (60s auf freq_min ohne Druckaufbau -> Stop),
    Ueberdruck-Stop (Druck > SP+0.3bar bei flow<1 -> sofortiger Stop)
    - Druckspitzen-Erkennung (Hahn-zu): konfigurierbarer Schwellwert (default 0.4bar/3s),
    sauberer Sto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
2026-04-30 fix: presets.js mqtt import fehlt - lock/clear war wirkungslos
    mqtt.sendCmd() in apply() mode=2 warf ReferenceError weil der
    Import fehlte. Dadurch crashte heartbeat() bevor lockUntil gesetzt
    wurde, und clear() kehrte sofort zurück (lockUntil === 0).
    Zusätzlich: beim Wechsel von mode=2 auf mode=0/1 wird die Pumpe
    jetzt explizit gestoppt, statt den PI-Regler ohne Stop zu übernehmen.
2026-04-30 feat: manueller Stop als Notstop - Pumpe bleibt aus bis manueller Start
    manualStopped-Flag in pressureCtrl verhindert auto-restart durch tick().
    - mode=2: Pumpe wurde nach manuellem Stop sofort neu gestartet -> fix
    - PI-Modus: p_on-Bedingung respektiert Flag
    - REST /v20/stop setzt Flag, /v20/start und preset-Wechsel loeschen es
2026-04-30 fix: pumpState-Sync beim Wechsel von mode=2 auf Normal
    Im mode=2 wurde pumpState nie gesetzt (PI-intern). Beim Rueckwechsel
    auf Normal dachte der PI-Regler die Pumpe sei aus (pumpState=0) waehrend
    V20 mit 37Hz weiterlief. forceStop() synct pumpState=0 + stop-Befehl.
2026-05-01 Add Python backend for Pi 3B+ solo-brain migration
    Komplett-Rewrite des Docker-Backends in Python (FastAPI + pymodbus +
    paho-mqtt + APScheduler). 1:1-Port der Steuerlogik mit identischen
    Tunings — die PI-Druckregelung (Kp=8, Ki=1, Trockenlauf-Schutz,
    Spike-Detect, Min-Freq-Timeout) ist bewusst werttreu zu pressureCtrl.js.
    Module:
    - pressure_ctrl.py: PI-Regler mit allen Schutzmechanismen
    - modbus_rtu.py: V20-Master via USB-RS485 oder TTL-Adapter am Pi-UART
    - modbus_tcp.py: TCP-Server :502, LOGO schreibt Sensoren in Reg 2/3/4
    - mqtt_client.py: bestehender Broker 192.168.1.136:1883, on_connected
    Republish für HA-Discovery
    - ha_discovery.py: Auto-Discovery für ~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
    [config.py, ha_discovery.py, irrigation.py, main.py, modbus_rtu.py, modbus_tcp.py, mqtt_client.py]
2026-05-01 Add Next.js frontend for Pi 3B+ HMI dashboard
    Industrie-HMI-Dashboard für die Pi-Pumpensteuerung. Standalone-Build,
    läuft als systemd-Service hinter nginx.
    Theme strikt nach Spec:
    - Hintergrund #ffffff, Primär #2588eb, OK #14c957, Warn #ffa000, Fehler #ff0000
    - Tabular-Nums für KPIs, Touch-Targets ≥48 px, Mobile-First
    - UI-Strings deutsch, Aktionen englisch (Start/Stop/Auto)
    Pages:
    - /dashboard: KPI Druck/Durchfluss/Hz, Pumpenstatus + Hold-Start,
    Zonen-Übersicht, Warnungen
    - /control: Manuelle V20-Steuerung, Hz-Slider, Programm-Start
    - /zones: Wetter+ET0, alle Zonen mit Bodenfeuchte/Defizit
    - /analytics: Echte historische Charts aus SQLite (1h/6h/24h/7T) mit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
2026-05-01 Add ops, OTA pipeline and migration docs for Pi deployment
    systemd / nginx / OTA / Setup-Skript:
    - systemd-Units für backend (uvicorn) + frontend (Next.js standalone)
    + ota-Timer (60-min-Check)
    - nginx-Config: TLS, /api+/ws → Backend, / → Next.js
    - ota/update.sh: GitHub-Release-Pull, minisign-Verifikation, atomarer
    Symlink-Swap, Smoke-Test, Rollback
    - setup.sh: Erstinstallation in einem Rutsch (Pakete, User, UART-
    Konfig mit disable-bt, Erst-Build aus Repo, nginx-TLS, Services)
    CI/CD:
    - .github/workflows/pi-release.yml — Tag-Push baut Backend+Frontend,
    signiert das Tarball mit minisign, hängt es ans GitHub-Release
    Dokumentation auf Repo-Ebene:
    - STATUS.md: was umgesetzt ist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
2026-05-01 fix: Pumpe pendelt während aktiver Bewässerung
    Symptom: Pumpe schaltet ständig an und aus während ein Bewässerungs-
    programm läuft, obwohl Verbraucher offen sind.
    Ursache: Drei Stop-Mechanismen im Druck-PI sind für manuellen
    Hahn-Betrieb getunt, nicht für gepulste Magnetventil-Bewässerung
    mit kurzen Pausen zwischen Zonen:
    1. p_off-Hart-Stop (4.0 bar): Kein Flow-Check. Druck schießt beim
    kurzen Schließen eines Magnetventils über 4.0 → STOP. Nächste Zone
    öffnet → Druck < p_on → START. Dauer-Pendeln.
    2. Hahn-zu-Spike-Detect (+0.4 bar in 3s): Triggert fälschlich beim
    Zonenwechsel, wenn das nächste Ventil noch nicht offen ist.
    3. No-demand-Shutdown (5s flow<1+Dr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
2026-05-01 Fix Pi-Setup: korrekte Repo-URL und Ownership beim Erst-Release
    - INSTALL.md / pi/ops/README.md: Clone-URL auf Pumpensteuerung.git mit -b
    pi-migration korrigiert; OTA GITHUB_REPO entsprechend angepasst.
    - setup.sh: chown auf $TARGET vor dem venv-Build, sonst scheitert
    `sudo -u pumpe python3 -m venv` mit Permission denied, weil mkdir als
    root das Verzeichnis anlegt.
2026-05-01 Fix Pi-Setup [1/9]: nodesource-Repo vor apt-get install einrichten
    Debians 'npm' zieht libnode108, das mit nodesource-nodejs kollidiert. Lösung:
    NodeSource-Repo vor dem apt-get-Block einrichten und 'npm' aus der Paketliste
    entfernen (nodesource-nodejs bringt npm bereits mit).
2026-05-01 Fix Pi-Setup [5/9]: package-lock.json hinzufügen, npm ci --legacy-peer-deps
    npm ci scheiterte weil kein Lockfile im Repo war. Lockfile generiert und
    committed; --legacy-peer-deps für peer-dep-Konflikte in den Dependencies.
2026-05-01 Fix: pymodbus auf <3.7 pinnen (ModbusSlaveContext in 3.7 entfernt)
    pymodbus 3.7 hat die Server-API umgebaut und ModbusSlaveContext aus
    pymodbus.datastore entfernt. Pin auf >=3.6,<3.7 bis Code auf neue API
    portiert wird.
2026-05-01 Fix: Durchfluss unter 5 L/min auf 0 setzen (Sensor-Untergrenze)
    Sensor misst zuverlässig ab 5 L/min; kleinere Werte sind Rauschen
    und wurden fälschlicherweise als ~2 L/min angezeigt.
    [modbus_tcp.py]
2026-05-01 chore: Docker-Stack, ESP32-Firmware und PlatformIO aus Repo entfernen
    Pi 3B+ übernimmt alle Steuerungslogik direkt — Docker-Backend (Node.js)
    und ESP32-Firmware (PlatformIO/C++) werden nicht mehr benötigt.
    Gelöscht:
    - docker/ (Node.js-Backend + nginx + Docker-Frontend)
    - src/ (ESP32-Firmware)
    - include/, lib/, test/, platformio.ini, partitions.csv (PlatformIO)
    - docker-compose.yml, docker-stack.yml
    - .github/workflows/build.yml (Docker-Build → ersetzt durch pi-release.yml)
    CLAUDE.md auf Pi-Only-Architektur aktualisiert.
    [partitions.csv]
2026-05-01 fix: Hz-Anzeige 50× zu hoch + Pumpen-Pendeln bei Niedrig-Entnahme
    Zwei zusammenhängende Bugs in der V20-Steuerung:
    1) modbus_rtu.py: Hz-Skalierungs-Bug
    FREQ_READ_SCALE = 1/327.68 = 50/16384, also liefert
    `hiw * FREQ_READ_SCALE` direkt die Hz. Das zusätzliche `* 50.0`
    war ein Skalierungsfehler — 12 Hz wurden als 600 Hz angezeigt,
    22.8 Hz als 1140 Hz. Das deckt sich mit den Werten, die in der
    UI sichtbar waren.
    2) pressure_ctrl.py: Pumpe pendelt bei kleiner Wasserentnahme
    Der Flow-Sensor hat einen Messbereich ab 5 L/min — darunter
    liefert er 0 (per Filter in modbus_tcp.py). Die Stop-Checks
    (Überdruck, No-demand, Trockenlauf) prüften aber `flow < 1.0`
    gegen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
    [modbus_rtu.py, pressure_ctrl.py]
2026-05-01 wip: UI-Redesign Phase 1 — neue Komponenten + erweiterte API
    Vorbereitende Arbeiten für das UI-Redesign:
    - components/empty-state.tsx: Wiederverwendbarer Leerstand mit Icon, Titel,
    Beschreibung und optionalem CTA-Button.
    - components/weather-widget.tsx: Wetter-Anzeige mit Lucide-Icons, Tone-System,
    spezieller "Keine Wetterdaten"-State mit Hinweis auf MQTT-Topic.
    - components/irrigation-advisor.tsx: Bewässerungs-Assistent zeigt
    Decision (allowed/reason), nächsten Lauf, Wasser-Budget, Runtime-Faktor.
    - lib/types.ts: Preset und OtaStatus Interfaces ergänzt.
    - lib/api.ts: Endpoints für Preset-CRUD (savePreset, deletePreset,
    fetchPresets), Programm-CRUD (fetchPrograms, saveProgram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
2026-05-01 feat: Batch 2–4 — visuelles Redesign, Preset-CRUD, Programm-Editor, OTA
    - zone-card.tsx: farbige linke Border je nach State (ok/trocken/läuft)
    - zones/page.tsx: IrrigationAdvisor + WeatherWidget oben, zone Borders
    - dashboard/page.tsx: Warnungen-Section nur wenn warnings.length > 0
    - control/page.tsx: Preset-Selector als prominenten Block oben
    - settings/page.tsx: vollständiges Preset-CRUD, Programm/Zonen-Editor, OTA-Sektion
    - state.py: OtaState-Klasse hinzugefügt
    - routes.py: GET/POST /api/ota/status, /ota/check, /ota/log Endpoints
    [state.py]
2026-05-01 Prevent early pressure spike shutdown
    [pressure_ctrl.py]
2026-05-01 Clamp V20 frequency during pump start
2026-05-01 Stop V20 when pressure signal is missing
    [pressure_ctrl.py]
2026-05-01 Support legacy LOGO flow scaling
2026-05-01 Fix MQTT irrigation weather ingestion
    [irrigation.py, main.py]
2026-05-01 Add Smart ET wizard and OTA release flow
2026-05-02 feat: redesign pump ui shell
2026-05-02 feat: add tap pressure preset mode
2026-05-02 feat: configure tap pressure per preset
2026-05-03 docs: adapt ota guide to pump project
2026-05-03 fix: align irrigation zone mqtt id
    [irrigation.py]
2026-05-03 fix: allow fixed frequency below pi minimum
    [modbus_rtu.py]
2026-05-03 fix: start pump with active fixed preset frequency
2026-05-03 feat: pause irrigation on pump stop
2026-05-03 feat: implement Claude Design handoff UI exactly
    - Dashboard: 4 KPI-Tiles (Druck/Durchfluss/Frequenz/Leistung), ActionTiles,
    Wasserbedarf+Faktor, Zonen-Status Grid
    - TopBar: inline Live-Metriken (bar/L/min/Hz) mit Farbakzenten, PUMPE AN Badge
    - BottomNav: 6 Tabs (Dashboard/Zonen/Wetter/Assistent/Verlauf/Einst.), grüne Aktivlinie
    - Zones: Decision-Summary, expandierbare Zone-Cards
    - Analytics: Verlauf ohne SortablePanels, farbige History-Balken
    - Settings: Tab-Navigation statt SortablePanels
    - Neu: app/weather/page.tsx, app/assistant/page.tsx
2026-05-04 fix: clarify irrigation metrics and next run
    [irrigation.py]
2026-05-05 v0.1.1: fix weather domain isolation - Ecowitt never overwrites OWM forecast fields
    [irrigation.py]
2026-05-05 v0.1.32: fix missing started_at/total_planned_s fields in IrrigationDecision + weather domain fix
    [state.py]
2026-05-10 feat: Capacitor-App, PWA, Sperrzeit-Override für Manuell + Doku-Refresh
    - Bewässerung: blocked_days/blocked_window blockieren nur noch Auto, manueller
    Lauf ignoriert Sperren (außer Safety) — User-Entscheidung Mai 2026
    - Capacitor-Wrapper-App im Remote-URL-Modus (lädt UI von https://pumpe.local)
    - PWA: next-pwa Service-Worker, Workbox-Caching für offline-fähigen Wrapper
    - DEPLOYMENT.md: schneller Iterations-Pfad (scp+tar) dokumentiert
    - Frontend: neuer DurationPicker, Dashboard/Settings/Weather refactoriert,
    TopBar minimalistisch, Theme-Provider überarbeitet
    - weather_provider, irrigation: kleinere Fixes
    - nginx: HTTPS-Setup für PWA + APK-Download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
    [irrigation.py, weather_provider.py]
2026-05-10 feat: Ventile direkt per MQTT, Verlauf erweitert, Live-Timer, Diverses
    Ventil-Schaltung
    - Pi schaltet Magnetventile direkt per MQTT auf den ESPHome-ESP32
    (pumpensteuerung/valve/<zone>/set), HA-Automation entfällt
    - Backend subscribt valve/+/state + availability, AppState gepflegt
    - POST /api/valve/{zone}/{open|close} mit 15-min-Watchdog für
    manuelles Open, blockiert während Bewässerung läuft
    - Settings-Tab "Ventile" mit Live-Status (rot=offen/pulsierend, grün=zu)
    Verlauf
    - pressure_log um power + water_temp erweitert (idempotente
    Schema-Migration), Sampler schreibt mit
    - /verlauf zeigt jetzt 5 Charts: Druck, Durchfluss, Frequenz,
    Leistung, Wassertemperatur
    Sonstiges
    - Wassert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
2026-05-11 fix(settings): Nachsaat minimiert per Default, Preset-Buttons brechen sauber um
2026-05-11 fix(weather): Stormglass-Params als Komma-Liste statt wiederholtem Query-Param
    Stormglass-API berücksichtigt bei wiederholtem ?params=X&params=Y nur den
    ersten Eintrag (meta.params zeigte nur airTemperature). Forecast-Felder
    waren dadurch dauerhaft 0.0. Komma-getrennte Liste in einem params= Wert
    liefert alle Parameter wie erwartet.
    [weather_provider.py]
2026-05-12 fix(weather): uvIndex aus Stormglass-Params entfernt (kein gültiger API-Param)
    Stormglass kennt keinen uvIndex-Parameter (Naming aus OWM). Bei wiederholtem
    ?params=X&params=Y wurde das ungültige uvIndex still verschluckt, bei
    Komma-Liste lehnt die API den ganzen Request mit 422 ab. uv_index bleibt
    weiterhin null im Payload (val() liefert None für fehlenden Key).
    Zusätzlich: bessere Fehlerausgabe (HTTP-Status + Response-Body statt nur
    generic httpx-Exception) für künftige Diagnose.
    [weather_provider.py]
2026-05-12 feat(weather): Refresh nur in Tagesfenster, Fehler verzögern nicht den nächsten Versuch
    Stormglass Free Tier hat 10 Requests/Tag. Vorher: alle 3h ab Service-Start
    (Nachts-Refreshs verbrennen Quota, Fehler blockierten 3h bis nächster Try).
    Jetzt: 9 feste Slots in Lokalzeit (5,7,9,11,13,15,17,19,21) mit min. 90 min
    Abstand zwischen erfolgreichen Refreshs. Fehlgeschlagene Refreshs setzen
    last_refresh_ok nicht — nächster Slot versucht es direkt erneut. 1 Token
    bleibt für manuelle Refreshs reserviert.
2026-05-12 feat(weather): Cool-Down nach 3 Fehlversuchen + roter Warnhinweis im Frontend
    Schützt das Stormglass-Token-Budget bei strukturellem Fehler (ungültiger
    Param, Key gesperrt etc.). Nach 3 aufeinanderfolgenden Fehlern Pause bis
    Tageswechsel (Berlin-Zeit). Erfolg setzt fail_count=0 und cooldown_until=null.
    Frontend zeigt rotes Banner im Wetter-Tab mit letzter Fehlermeldung.
    [weather_provider.py]
2026-05-12 fix(weather): Tipps unterscheiden vergangenen Regen und Vorhersage, koppeln sich
    Vorher widersprüchlich: 'Kein Regen — ET-Ausgleich nötig' UND gleichzeitig
    'Heute +5,8 mm — Lauf verschieben'. Jetzt:
    - Tipp 3 sagt explizit 'Letzte 24 h' und schaltet auf neutral, wenn Forecast
    signifikanten Regen ankündigt (Boden trocken, aber Eingriff unnötig).
    - Tipp 4 sagt explizit 'Vorhersage nächste 24 h'.
2026-06-24 feat(fan): Gehäuselüfter an GPIO 17 folgt V20-Run mit Nachlauf
    Neuer fan_ctrl: schaltet Lüfter (IRLZ44N Low-Side an GPIO 17) ein,
    sobald v20.running, und nach 120s Nachlauf wieder aus. GPIO-Zugriff
    gekapselt, fällt ohne RPi.GPIO (Dev-Maschine) auf No-Op zurück.
    RPi.GPIO als Pi-only Dependency (platform_machine arm).
2026-06-24 fix(fan): rpi-lgpio statt RPi.GPIO (kein Compiler/python3-dev nötig)
    RPi.GPIO ist C-Extension und scheitert im OTA-venv an fehlendem
    Python.h (python3-dev). rpi-lgpio ist pure-Python Drop-in mit
    identischer RPi.GPIO-API (piwheels-Wheel), empfohlen auf Bookworm.
    fan_ctrl.py bleibt unverändert.
2026-06-24 fix(fan): GPIO-Init vollständig kapseln, Backend nie crashen lassen
    setmode/setup lagen außerhalb des try-Blocks → fehlende gpiochip-
    Rechte (Service-User nicht in gpio-Gruppe) killten das ganze Backend
    statt auf No-Op zurückzufallen. Jetzt fängt _init_gpio jeden Fehler.
    [fan_ctrl.py]
2026-06-24 feat(fan+irrigation): Lüftersteuerung mit Modi/PWM + Auto-Bewässerung fixen
    Lüfter (kühlt V20-Kühlkörper):
    - FanState erweitert: mode (auto/pwm_auto/aus), postrun_s, PWM-Params
    - fan_ctrl: Hardware-PWM (sysfs, 25kHz) auf GPIO18 mit HIGH/LOW-Fallback,
    pwm_auto regelt Drehzahl linear nach FU-Strom (v20.current)
    - load/save/set_config (fan.json), POST /api/fan, deps.fan_ctrl
    - TopBar: drehendes Lüfter-Icon + PWM%, Settings-Sektion "Lüfter"
    Auto-Bewässerung löste nie aus (Defizit blieb 0):
    - Wasserbilanz wird im Tick jetzt für ALLE smart_et-Programme täglich
    fortgeschrieben, nicht nur fürs nächste (recompute evaluiert nur eins)
    - Scheduler: Catch-up-Fenster (10min) statt exakt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
    [fan_ctrl.py, irrigation.py, main.py, persistence.py, state.py]
2026-06-24 fix(fan): Pin-Mux beim PWM-Init explizit auf ALT5 (PWM0) setzen
    Das pwm-Overlay aktiviert den PWM-Block, schaltet GPIO18 aber nicht
    zuverlässig auf die PWM-Alt-Funktion — der Pin blieb auf Input, der
    12V-Lüfter sah kein Signal und lief auf Failsafe-Vollgas. fan_ctrl
    setzt den Mux jetzt selbst per `pinctrl set 18 a5`, übersteht Reboots.
    [fan_ctrl.py]
2026-06-24 fix(fan): Boot-Race für Hardware-PWM beheben (Code-Retry + systemd + setup)
    Beim Boot war pwm0 noch nicht exportiert/berechtigt, wenn das Backend
    startete → PWM scheiterte, nur ein manueller Restart half. Jetzt dreifach
    abgesichert:
    - fan_ctrl: tick() holt den HW-PWM-Init nach, falls er beim Start scheiterte
    - pumpe-backend.service: ExecStartPre exportiert pwm0 + setzt Mux a5 + Rechte
    (als root, vor dem Start); SupplementaryGroups um gpio ergänzt
    - setup.sh: dtparam=audio=off + dtoverlay=pwm pin=18 func=5, udev-Regel für
    PWM-sysfs-Rechte, pumpe in gpio-Gruppe — überlebt Neuinstallation
    [fan_ctrl.py]
2026-06-24 fix(pwa): neue Builds sofort aktiv (skipWaiting + NetworkFirst-Navigation)
    Service Worker cachte Seiten via CacheFirst/precache → nach einem Deploy
    zeigten Browser UND App weiter die alte UI (z.B. fehlender Lüfter-Tab),
    bis manuell der Cache geleert wurde. Jetzt: skipWaiting/clientsClaim +
    HTML-Navigation als NetworkFirst (Cache nur Offline-Fallback). Deploys
    schlagen ab dem nächsten Start ohne Cache-Leeren durch.
2026-06-24 docs: Lüftersteuerung, Bewässerungs-Fix, GPIO-Belegung & PWA-Cache
    CLAUDE.md: fan_ctrl in Modul-Tabelle, neuer Lüfter-Abschnitt (GPIO18/PWM0,
    Modi, Hardware-Setup, Boot-Race), Bewässerungs-Modell um täglichen
    Defizit-Aufbau + Catch-up ergänzt, GPIO-Belegungstabelle, erweiterte
    Fehler-Tabelle (Lüfter/PWM/Permissions/PWA/Auto-Bewässerung).
    DEPLOYMENT.md: PWA-Cache-Eintrag um SW-Fix + Fully-Kiosk-Anleitung.
2026-06-25 fix(irrigation): ET0 realistischer + Wasserbilanz erst tagsüber ziehen
    Auto-Bewässerung baute das Defizit kaum auf (et0_mm=0.86 statt ~5 mm),
    deshalb wurde die Auslöse-Schwelle nie erreicht. Zwei Ursachen:
    - _update_water_balance lief direkt nach Mitternacht → ET0 aus nächtlichen
    Temperaturen viel zu niedrig. Jetzt erst ab BALANCE_HOUR (9 Uhr lokal).
    - _estimate_et0_simple war zu niedrig kalibriert. Hargreaves-näher: stärkerer
    Temperatur-Einfluss + Tagesspanne als Einstrahlungs-Proxy (robust nachts),
    Sommertag ~5 mm statt ~2.6. Garten löst damit nach ~4 Trockentagen aus.
    [irrigation.py, weather_provider.py]
2026-06-25 fix(dashboard): Wasserbedarf zeigt echtes Zonen-Defizit + Sperrzeit klarer
    - "Wasserbedarf" zeigte water_budget_mm der aktuellen Decision → 0,0 mm,
    wenn das angezeigte Programm gerade per blocked_window gesperrt ist.
    Jetzt Fallback auf das größte aktive Zonen-Defizit, also den realen Bedarf.
    - "Grund"-Chip übersetzt decision.reason; "Sperrzeit aktiv" nennt jetzt das
    betroffene Programm (nur dieses Programm gesperrt, nicht generell).
2026-06-25 feat(fan): Drehzahl nach Laufzeit/Wärme statt FU-Strom
    Strom-Kopplung war physikalisch ungünstig: kurzer 50-Hz-Lauf → Kühlkörper
    noch kalt, Lüfter müsste nicht aufdrehen. Jetzt:
    - "auto" = fester Sockel (fixed_pwm, default 40%) an/aus, Nachlauf 30s
    - "thermal" = thermischer Akku (heat_index 0..1): steigt bei Lauf
    (heat_rise_min), fällt bei Stillstand (heat_fall_min). Lüfter rampt von
    pwm_min (kalt) auf pwm_max (heiß) → leise bei kurzen Läufen, voll erst
    wenn Kühlkörper real warm. Robust gegen kurze Pausen (Wärme bleibt erhalten).
    - Settings + TopBar angepasst; alte src_*-Strom-Parameter entfernt.
    Werte mit Schätz-Defaults, per UI justierbar nach echter Messung.
    Co-Au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
    [fan_ctrl.py, state.py]
2026-06-25 fix(fan): alten Modus pwm_auto beim Laden auf thermal migrieren
    Bestehende fan.json hatte mode="pwm_auto" (entfernt) → UI zeigte ungültigen
    Modus. load() migriert jeden unbekannten Modus auf "thermal".
    [fan_ctrl.py]
2026-07-30 fix(irrigation): Automatik loeste nie aus — Bilanz-Timing, Doppelzaehlung, Schwelle
    Die Auto-Bewaesserung wurde seit Wochen jeden Tag mit "Regen kompensiert
    Defizit" uebersprungen, obwohl kein Regen fiel. Vier zusammenwirkende Ursachen:
    1. Bilanz-Timing (Hauptursache): _update_water_balance() verweigerte vor
    BALANCE_HOUR=9 die Buchung. Die Programme starten aber 06:00/07:30/10:00 —
    sie sahen also taeglich ein Defizit von ~0 und wurden uebersprungen, bevor
    der Tagesbedarf ueberhaupt gebucht war. Danach war der Tagesversuch
    verbraucht. Jetzt wird rueckwirkend der abgelaufene Tag gebucht, dessen
    ET0 morgens feststeht — BALANCE_HOUR entfaellt.
    2. Regen-Doppelzaehlung: rain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
    [irrigation.py]
2026-07-30 feat(ui): Assistent-Knopf + aufgeraeumte Startseite
    Die Oberflaeche war fuer die taegliche Bedienung zu voll: fuenf KPI-Kacheln,
    fuenf Chips, Programmwahl, Fortschritt und Hinweistext gleichzeitig sichtbar.
    Startseite
    - Oben ein Satz, der alles sagt ("Naechste Bewaesserung Fr 06:00" bzw.
    "Garten laeuft - noch 12:30") plus Klartext-Grund statt Backend-Jargon.
    - Zwei grosse Knoepfe: giessen / stoppen.
    - Alle Technikwerte (bar, Hz, W, Entscheidungs-Chips) hinter "Details
    anzeigen". Die Wahl wird pro Geraet in localStorage gemerkt.
    Assistent
    - Schwebender Knopf unten rechts auf jeder Seite, statt eigenem Tab.
    Freitext oder Diktat (Web Speech API, wo verfuegbar).
    - Neues Backend-Modul ass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
    [assistant.py]
2026-07-30 fix(assistant): Spracheingabe funktioniert in der Android-App
    Diktieren war in der APK wirkungslos: im Android-WebView fehlt die Web
    Speech API meist ganz, ausserdem hatte das Manifest keine Mikrofon-
    Berechtigung — der Knopf war damit tot.
    - @capacitor-community/speech-recognition ergaenzt: nutzt Androids native
    Spracherkennung statt der Browser-API.
    - AndroidManifest: RECORD_AUDIO plus <queries> fuer RecognitionService
    (ohne die Abfrage meldet Android 11+ die Erkennung faelschlich als
    nicht verfuegbar).
    - Neues Modul lib/speech.ts kapselt drei Stufen: natives Plugin (App),
    Web Speech API (Safari/iOS, Desktop-Chrome), sonst nichts. Das Plugin
    wird dynamisch geladen, damit der W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
2026-07-30 docs: APK-Build — SDK-Pfad, JDK-Wahl, Signaturpruefung, Spracheingabe
    Beim Build fuer die Spracheingabe sind zwei Stolpersteine aufgetreten, die
    in der Doku fehlten: local.properties ist maschinenspezifisch und nicht im
    Repo (Build bricht sonst mit "SDK location not found" ab), und ein zu neues
    JDK im PATH laesst Gradle 8.14 scheitern — JBR aus Android Studio nutzen.
    Ausserdem: Signatur laesst sich nicht an META-INF/*.RSA ablesen (v2/v3 stehen
    im ZIP-Trailer) — apksigner verify ist der richtige Weg. Und ein Abschnitt,
    warum die Spracheingabe ein natives Plugin braucht statt der Web Speech API.
2026-07-30 fix(assistant): Mikrofon blieb unsichtbar + Diagnose ohne Adresszeile
    Das Mikrofon-Symbol erschien in der App nicht. Ursache: faellt der Plugin-
    Proxy auf seine Web-Implementierung zurueck, wirft available() eine
    "unimplemented"-Exception statt false zu liefern — mein try/catch hat sie
    geschluckt und die Spracheingabe pauschal als nicht verfuegbar gewertet.
    Jetzt wird zuerst Capacitor.isPluginAvailable("SpeechRecognition") gefragt,
    also die Bridge selbst, statt sich auf den Aufruf zu verlassen.
    Ausserdem: Der Assistent versteht den Befehl "diagnose" und berichtet in
    Klartext, ob Bridge, Plugin, Geraete-Erkennung und Mikrofon-Freigabe da
    sind. Die App laeuft im Vollbild ohne Adresszeile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
2026-07-30 docs: Deploy-Pruefung fuer den Service Worker ergaenzt
    public/ wird von "npm run build" nicht nach .next/standalone kopiert. Fehlt
    es beim Deploy, liefert der Pi keinen sw.js — installierte Apps behalten
    dann ihren alten Service Worker und laden weiter dessen alte JS-Chunks,
    obwohl der Pi die neue Seite korrekt ausliefert. Das Symptom ist stumm:
    die Seite laedt, nur die Aenderungen fehlen.
    Pruefzeile (sw.js muss 200 liefern) plus Gegenprobe, dass der Chunk-Hash
    im Service Worker zu dem der Seite passt.
2026-07-30 fix(assistant): Mikrofon immer zeigen statt still zu verstecken
    Das Symbol wurde ausgeblendet, wenn speechAvailable() false lieferte. Damit
    war am Geraet nicht unterscheidbar, ob die Spracherkennung fehlt oder die
    App nur alten Code geladen hatte — beides sah gleich aus (nichts).
    Jetzt ist der Knopf immer da und nennt bei einem Fehlschlag den Grund
    (Bridge, Plugin, Geraete-Erkennung, Mikrofon-Freigabe). Ausserdem eine
    Bau-Kennung im Kopf des Assistenten, an der sofort ablesbar ist, welcher
    Stand tatsaechlich geladen ist.
2026-07-30 fix(assistant): Sprachfehler nicht mehr verschlucken
    "Ich hoere zu..." erschien, danach passierte nichts und Android fragte nie
    nach der Mikrofon-Freigabe. Zwei Ursachen im Code:
    - requestPermissions()/checkPermissions() hingen an .catch(), das jeden
    Fehler in ein stilles null verwandelt hat — eine verweigerte oder nie
    erschienene Abfrage sah aus wie "nichts verstanden".
    - Fehlt das native Plugin, lief der Web-Zweig weiter. Im Android-WebView ist
    webkitSpeechRecognition aber eine Attrappe: start() wirft nicht, onend
    feuert sofort, eine Berechtigungsabfrage kommt nie.
    Jetzt werden beide Faelle als Fehler mit Klartext gemeldet. Die Diagnose
    listet zusaetzlich auf, welche Plugins di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
2026-07-30 fix(assistant): Zeitgrenze gegen stumm haengende Bridge-Aufrufe
    "Ich hoere zu…" blieb stehen — kein Ergebnis, kein Fehler, keine Android-
    Berechtigungsabfrage. Ursache: Geht ein Capacitor-Bridge-Aufruf ins Leere,
    bleibt seine Promise fuer immer offen. Das await kehrte also nie zurueck,
    weshalb auch der catch-Zweig nie erreicht wurde und nichts im Chat landete.
    Alle Bridge-Aufrufe laufen jetzt durch withTimeout(): Plugin-Suche und
    Freigabepruefung brechen nach 4-5s ab, Freigabeanfrage und Aufnahme nach
    60s (dort wartet der Nutzer bewusst). Die Diagnose ist ebenfalls abgesichert,
    damit wenigstens die Fehlermeldung erscheint.
2026-07-30 fix(assistant): Fehlschlag nicht dauerhaft merken, Timeout realistisch
    Die Diagnose meldete alles gruen (Bridge kennt SpeechRecognition, Geraete-
    Erkennung verfuegbar, Freigabe "prompt"), listenOnce() lief trotzdem in
    "Plugin-Suche: keine Antwort nach 4s".
    Ursache war ein Logikfehler im Cache: loadNative() hat auch Fehlschlaege als
    nativeCache = null gespeichert. Da null ein gueltiger Cache-Wert war, wurde
    das Plugin nach dem ersten Timeout nie wieder probiert. Und der Timeout von
    4s war zu knapp — der Plugin-Chunk wird beim ersten Mal ueber WLAN vom Pi
    nachgeladen. Die Diagnose importierte direkt, umging den Cache und
    funktionierte deshalb.
    Jetzt werden nur Erfolge gemerkt, das Laden be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
2026-07-30 debug(assistant): Sprachablauf Schritt fuer Schritt im Chat anzeigen
    Auch mit Zeitgrenzen kam am Geraet keinerlei Meldung. Um nicht weiter zu
    raten, meldet listenOnce() jetzt jeden Schritt sofort in den Chat: Plugin
    suchen, Freigabe pruefen, Freigabe anfragen, Aufnahme starten. Bleibt etwas
    stehen, zeigt die letzte sichtbare Zeile genau wo.
    Zusaetzlich eine harte Gesamtgrenze von 90s um den kompletten Ablauf —
    falls doch etwas ohne eigenes Zeitlimit haengt, kommt wenigstens eine
    Fehlermeldung statt endlosem "Ich hoere zu…".
2026-07-30 revert(assistant): Spracheingabe wieder entfernt
    Diktieren liess sich in der Android-App nicht zum Laufen bringen. Die
    Diagnose meldete alles gruen — Bridge kennt SpeechRecognition, Geraete-
    Erkennung verfuegbar, Freigabe "prompt" — der Aufruf kam trotzdem nie
    zurueck und Android zeigte nie den Berechtigungsdialog.
    Statt weiter daran zu bauen: entfernt. Es braucht das auch nicht, denn die
    Android-Tastatur hat ein eigenes Mikrofon, mit dem sich in die Eingabezeile
    des Assistenten diktieren laesst — auf dem iPhone ebenso.
    Entfernt: lib/speech.ts, Mikrofon-Knopf, "Ich hoere zu"-Anzeige, der
    diagnose-Sonderbefehl, die Bau-Kennung, das Plugin @capacitor-community/
    speech-recognition sowie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
2026-07-30 feat(verlauf): zeigt an, ob ein Lauf manuell oder per Automatik kam
    started_by (auto | manual | nachsaat) gab es im laufenden Betrieb bereits,
    wurde aber beim Schreiben der History nicht mitgegeben — im Verlauf war
    danach nicht mehr erkennbar, wer den Lauf ausgeloest hat.
    Jetzt wandert das Feld in run- und skip-Eintraege. Ein Schema-Update war
    nicht noetig: unbekannte Felder landen im payload-JSON und werden beim
    Lesen wieder aufgeloest.
    Im Verlauf steht jetzt eine farbige Marke hinter dem Programmnamen
    (Automatik gruen, Manuell gelb, Nachsaat lila), uebersprungene Termine sind
    zusaetzlich als solche gekennzeichnet. Aeltere Eintraege ohne das Feld
    bleiben unmarkiert.
    Verifiziert mit ein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
    [irrigation.py]
2026-07-30 fix(verlauf): neue Eintraege standen am Listenende statt oben
    Frisch protokollierte Laeufe tauchten im Verlauf nicht auf. Ursache war eine
    Sortier-Unstimmigkeit: list_irrigation_events() liefert absteigend (neueste
    zuerst), _add_history() haengte neue Eintraege aber per append hinten an.
    Die In-Memory-Liste war dadurch nicht durchgehend sortiert — sie begann mit
    dem juengsten Eintrag beim letzten Backend-Start, lief rueckwaerts, und alles
    seither Hinzugekommene stand ganz am Ende. Die Verlauf-Seite zeigt die ersten
    30 Eintraege und schnitt neue Laeufe damit systematisch ab.
    Jetzt wird vorne eingefuegt und am Limit abgeschnitten. _weekly_run_count()
    zaehlt nur und ist von der Reihenfolge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
    [irrigation.py]
2026-07-30 feat(dashboard): Prognose, wann das naechste Mal bewaessert wird
    Bisher zeigte die Startseite nur den naechsten Programm-Termin — bei
    Smart-ET sagt der aber nichts darueber aus, ob dann auch wirklich Wasser
    kommt. Die eigentliche Frage "wann wird gegossen?" liess sich nur durch
    Nachrechnen beantworten.
    Neu: irrigation.forecast() schreibt die taegliche Wasserbilanz fort und
    sucht je Zone den ersten Tag, an dem das Defizit die Startschwelle
    erreicht. Beruecksichtigt Sperrtage, den Skip-bei-Regen-Fall und verteilt
    die Regenprognose (24h/48h/7d) auf die kommenden Tage. Die noch nicht
    gebuchte Tagesbilanz wird vorgezogen — sonst waere die Prognose direkt
    nach einem Regen zu optimistisch.
    Au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
    [irrigation.py, state.py]
2026-07-30 feat(bilanz): Wasserbilanz laufend statt einmal taeglich fortschreiben
    Die Bilanz wurde einmal pro Tag gebucht (last_balance_date-Riegel). Dazwischen
    war das Defizit eingefroren: Regen am Nachmittag wirkte erst am naechsten
    Morgen, und die 6:00-Entscheidung rechnete mit den Zahlen des Vortags.
    Jetzt wird bei jedem Tick anteilig gebucht — der seit der letzten Buchung
    verstrichene Anteil der Tagesverdunstung drauf, der seither neu gefallene
    Regen ab (mind. 15 min Abstand, oder sofort bei neuem Regen). Rein aus
    lokalen Sensordaten, kostet also keine Stormglass-Abfrage.
    Regen wird als Zuwachs eines Zaehlers bestimmt, nicht als Absolutwert:
    - rain_today_mm (neu, Ecowitt "Daily Rain") ist kumu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
2026-07-30 fix(grund): "Regen kompensiert Defizit" auch ohne Regen angezeigt
    Im smart_et-Zweig gab es nur einen Skip-Grund, egal warum keine Zone faellig
    war. Bei 0.7 mm Regenprognose (Credit 0.35 mm) stand deshalb "Vorhergesagter
    Regen deckt das Defizit" auf der Startseite, obwohl es schlicht am noch nicht
    erreichten Bedarf lag — genau die Meldung, die schon vor dem Bilanz-Fix
    irregefuehrt hat.
    Jetzt wird unterschieden: ab 1 mm Regen-Credit weiter "Regen kompensiert
    Defizit", sonst "Boden noch feucht genug". Ausserdem meldet der Skip den
    tatsaechlichen Bedarf statt 0 mm.
    [irrigation.py]
2026-07-31 fix(verlauf): Skip-Eintraege nicht mehr minuetlich wiederholen
    Der Verlauf lief mit "Garten uebersprungen" voll — 30 Eintraege an einem
    Morgen. Ursache ist der Retry-Fix fuer temporaere Blocker: "Zeitfenster
    gesperrt" setzt last_auto_attempt_date bewusst nicht, damit spaeter erneut
    versucht wird. Jeder dieser Versuche schrieb aber einen History-Eintrag.
    Jetzt wird pro Programm, Grund und Tag nur der erste Skip protokolliert
    (_skip_logged, wird beim Tageswechsel geleert). Der Retry-Mechanismus bleibt
    unveraendert — nur das Protokollieren ist entkoppelt.
    Bestandsdaten bereinigt: 41 Duplikate entfernt, pro Tag/Programm/Grund
    blieb der erste Eintrag. Alle 89 echten Laeufe unangetastet.
    Co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
    [irrigation.py]
2026-07-31 feat(verlauf): Messwert-Diagramme eingeklappt, Historie zuerst
    Die Verlauf-Seite oeffnete mit fuenf Diagrammen; die Bewaesserungs-Historie
    — wonach dort eigentlich gesucht wird — stand darunter und war auf dem
    Handy erst nach laengerem Scrollen sichtbar.
    Jetzt steht die Historie oben, die Diagramme liegen hinter "Messwerte
    anzeigen". Die Auswahl wird pro Geraet in localStorage gemerkt (wie die
    Detail-Ansicht auf der Startseite).
    Nebeneffekt: Solange die Diagramme zugeklappt sind, laeuft auch das
    5-Sekunden-Polling der Druckhistorie nicht mehr.
    Ausserdem: Die Trennlinie zwischen den Eintraegen richtete sich nach
    history.length statt nach der angezeigten Menge — beim letzten sichtbare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
2026-08-03 docs: Pi-IP auf 192.168.20.156 aktualisiert, Netzwerk-Uebersicht ergaenzt
    Der Pi ist umgezogen. In der Doku standen drei verschiedene, allesamt
    veraltete Adressen (192.168.1.50 in INSTALL.md, 192.168.1.86 in
    DEPLOYMENT.md). Der MQTT-Broker bleibt vorerst 192.168.1.136 — sein Umzug
    nach 192.168.20.136 ist als anstehend vermerkt.
    Neu in CLAUDE.md: Netzwerk-Tabelle mit Pi, Broker und LOGO.
    Ausserdem dokumentiert:
    - SSH-User heisst tatsaechlich "pi" (INSTALL.md behauptete, der sei in
    neueren Images deaktiviert und man solle einen eigenen anlegen)
    - nach einem IP-Wechsel zeigt pumpe.local u.U. noch auf die alte Adresse
    (mDNS-Cache) — dann die IP direkt verwenden
    - der Pi haengt per DHCP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
2026-08-04 docs: LOGO-IP auf 192.168.20.15 aktualisiert
    LOGO wurde ins 192.168.20-Netz umgezogen und hat die .15 bekommen.
    Modbus-TCP-Verbindung zum Pi steht wieder, Sensordaten (Druck,
    Wassertemperatur) kommen an.
2026-08-11 chore: MQTT-Broker-IP auf 192.168.20.136 aktualisiert
    Broker ist ins gleiche Subnetz wie Pi/LOGO umgezogen (vorher 192.168.1.136).
    [config.py, mqtt_client.py]
2026-10-20 hardware: AIO-Steuerplatine Rev 0.1 – Spezifikation und KiCad-Schaltplan (CM5)
    Ersetzt LOGO 8.4 + AM2 + Pi 3B+ durch eine Platine mit Compute Module 5,
    230-V-Netzteil, 6 Universal-AI, 2 AO 0/4-20 mA, 4 DI, 2 Relais, isoliertem RS485.
    Schaltplan wird aus hardware/tools/gen_schematic.py erzeugt und gegen die
    KiCad-Netzliste geprüft.
    Claude-Session: https://claude.ai/code/session_019gH4tfEhDrFu8dTGZD88nH
2026-10-20 hardware: Rev 0.2 – ESP32-S3 (Steuerung) + M5Stack Stamp-P4 (App/HMI) statt CM5
    CM5 entfernt. Neu: ESP32-S3-WROOM-1 für Regelung/I/O/V20, Stamp-P4 mit
    LAN8720A-Ethernet und 7"-MIPI-DSI-Touch (FPC 15p), UART-Link mit Reset/Boot-
    Steuerung des S3 durch den P4, 5V->3,3V-Wandler, USB-Werkbankversorgung.
    I/O-Blätter unverändert. Netzliste geprüft (180 Netze, 0 Fehler).
    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
2026-10-20 hardware: Schaltplan im Block-Stil wie pool-pcb
    Neuer Generator tools/schblock.py: gestrichelte Funktionsblöcke mit Titel und
    Notizen, echte Drähte (eigener Router), Power-Symbole am Pin bzw. als Schiene,
    Global-Labels nur an Blockgrenzen. Netzliste weiterhin gegen die deklarierte
    Absicht geprüft (180 Netze, 0 Fehler), PWR_FLAGs ergänzt.
    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
2026-10-20 hardware: offizieller Stamp-P4-Footprint (M5Stack, mit STEP)
    Pads 1–65 gegen die Pinzuordnung in tools/stamp_p4_pins.py geprüft.
    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
2026-10-20 hardware: Sprungmarken im Schaltplan-PDF
    tools/pdf_links.py: Klick auf Power-Symbol/Label springt zur Quelle des Netzes
    (Regler, Netzteil, treibender Pin) bzw. zur Gegenseite; Quellen orange markiert.
    Positionen kommen aus link_map.json, die der Generator schreibt.
    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
